mickdassive/car_power_management_sytem/disrabution_controler/hardware/distrabution_controler.kicad_pcb

## KiCad design disrabution_controler/hardware/distrabution_controler.kicad_pcb (2025-07-08)

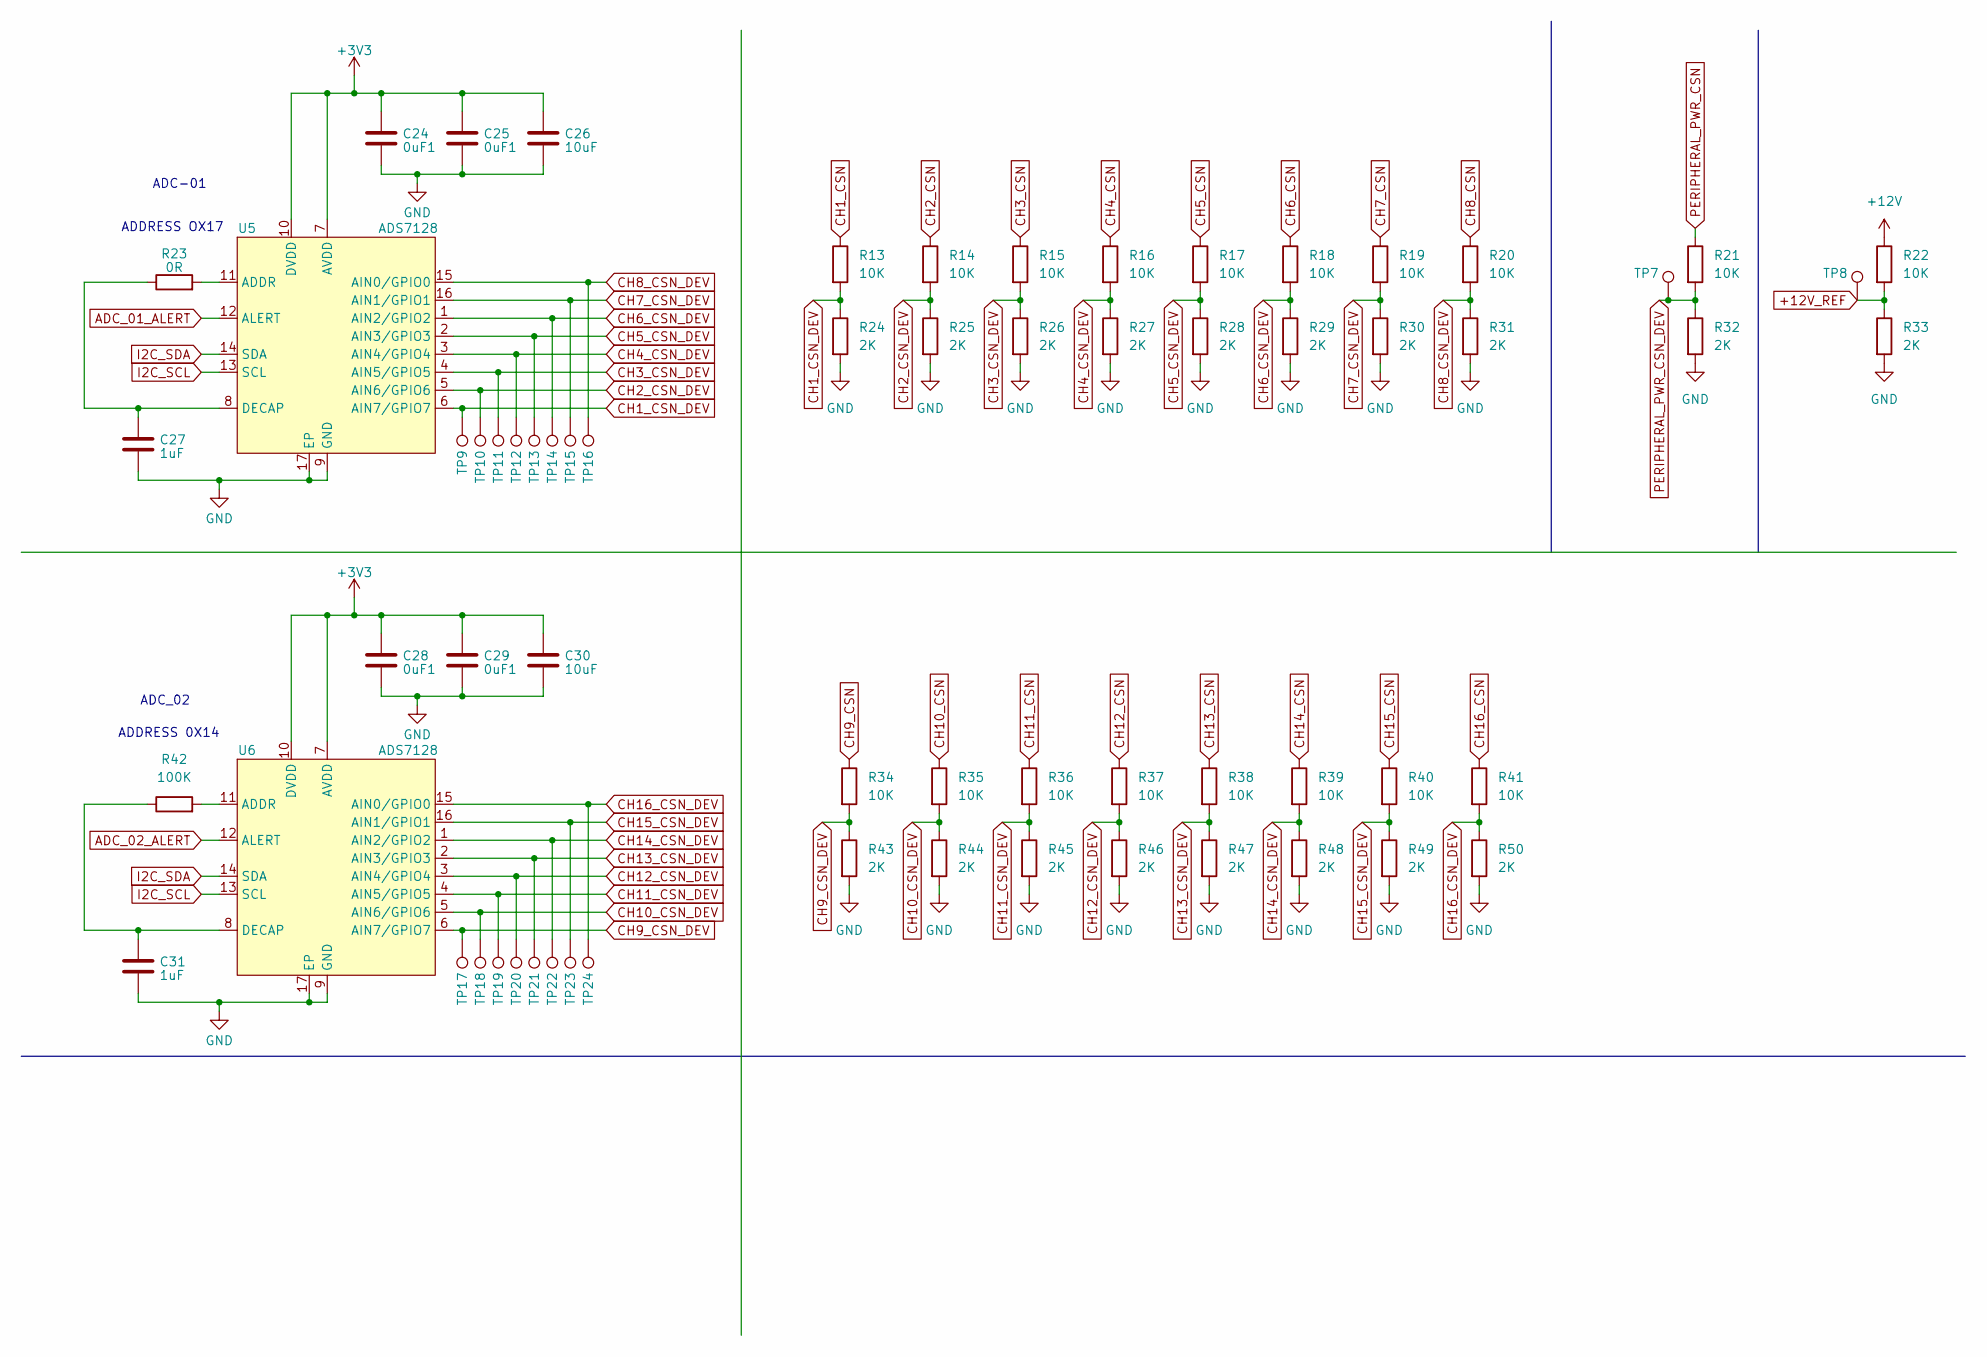
[picture p1: schematic ANALOUGE.kicad_sch]

Parts:
C24, C25, C28, C29: 0uF1; C_0603_1608Metric; Digikey Part Number 399-C0603C104M5RACTUCT-ND
C26, C30: 10uF; C_0603_1608Metric; Digikey Part Number 1276-1038-1-ND
C27, C31: 1uF; C_0603_1608Metric; Digikey Part Number 1276-1946-1-ND
R13, R14, R15, R16, R17, R18, R19, R20, R21, R22, R34, R35, R36, R37, R38, R39, R40, R41: 10K; R_0603_1608Metric; Digikey Part Number RMCF0603JT10K0CT-ND
R23: 0R; R_0603_1608Metric; Digikey Part Number 541-0.0GCT-ND
R24, R25, R26, R27, R28, R29, R30, R31, R32, R33, R43, R44, R45, R46, R47, R48, R49, R50: 2K; R_0603_1608Metric; Digikey Part Number 311-20.0KHRCT-ND
R42: 100K; R_0603_1608Metric; Digikey Part Number 541-100KHCT-ND
TP7, TP8, TP9, TP10, TP11, TP12, TP13, TP14, TP15, TP16, TP17, TP18, TP19, TP20, TP21, TP22, TP23, TP24: TestPoint_Pad_D1.0mm
U5, U6: ADS7128; WQFN-16-1EP_3x3mm_P0.5mm_EP1.6x1.6mm_ThermalVias; Digikey Part Number 296-ADS7128IRTERCT-ND

Connections:
+3V3: C24.1, C25.1, C26.1, C28.1, C29.1, C30.1, U5.7 (AVDD), U5.10 (DVDD), U6.7 (AVDD), U6.10 (DVDD); also elsewhere on the board
+12V: R22.1; also elsewhere on the board
+12V_REF: R22.2, R33.1, TP8.1; also elsewhere on the board
ADC_01_ALERT: U5.12 (ALERT); also elsewhere on the board
ADC_02_ALERT: U6.12 (ALERT); also elsewhere on the board
CH1_CSN: R13.1; also elsewhere on the board
CH1_CSN_DEV: R13.2, R24.1, TP9.1, U5.6 (AIN7/GPIO7)
CH2_CSN: R14.1; also elsewhere on the board
CH2_CSN_DEV: R14.2, R25.1, TP10.1, U5.5 (AIN6/GPIO6)
CH3_CSN: R15.1; also elsewhere on the board
CH3_CSN_DEV: R15.2, R26.1, TP11.1, U5.4 (AIN5/GPIO5)
CH4_CSN: R16.1; also elsewhere on the board
CH4_CSN_DEV: R16.2, R27.1, TP12.1, U5.3 (AIN4/GPIO4)
CH5_CSN: R17.1; also elsewhere on the board
CH5_CSN_DEV: R17.2, R28.1, TP13.1, U5.2 (AIN3/GPIO3)
CH6_CSN: R18.1; also elsewhere on the board
CH6_CSN_DEV: R18.2, R29.1, TP14.1, U5.1 (AIN2/GPIO2)
CH7_CSN: R19.1; also elsewhere on the board
CH7_CSN_DEV: R19.2, R30.1, TP15.1, U5.16 (AIN1/GPIO1)
CH8_CSN: R20.1; also elsewhere on the board
CH8_CSN_DEV: R20.2, R31.1, TP16.1, U5.15 (AIN0/GPIO0)
CH9_CSN: R34.1; also elsewhere on the board
CH9_CSN_DEV: R34.2, R43.1, TP17.1, U6.6 (AIN7/GPIO7)
CH10_CSN: R35.1; also elsewhere on the board
CH10_CSN_DEV: R35.2, R44.1, TP18.1, U6.5 (AIN6/GPIO6)
CH11_CSN: R36.1; also elsewhere on the board
CH11_CSN_DEV: R36.2, R45.1, TP19.1, U6.4 (AIN5/GPIO5)
CH12_CSN: R37.1; also elsewhere on the board
CH12_CSN_DEV: R37.2, R46.1, TP20.1, U6.3 (AIN4/GPIO4)
CH13_CSN: R38.1; also elsewhere on the board
CH13_CSN_DEV: R38.2, R47.1, TP21.1, U6.2 (AIN3/GPIO3)
CH14_CSN: R39.1; also elsewhere on the board
CH14_CSN_DEV: R39.2, R48.1, TP22.1, U6.1 (AIN2/GPIO2)
CH15_CSN: R40.1; also elsewhere on the board
CH15_CSN_DEV: R40.2, R49.1, TP23.1, U6.16 (AIN1/GPIO1)
CH16_CSN: R41.1; also elsewhere on the board
CH16_CSN_DEV: R41.2, R50.1, TP24.1, U6.15 (AIN0/GPIO0)
GND: C24.2, C25.2, C26.2, C27.2, C28.2, C29.2, C30.2, C31.2, R24.2, R25.2, R26.2, R27.2, R28.2, R29.2, R30.2, R31.2, R32.2, R33.2, R43.2, R44.2, R45.2, R46.2, R47.2, R48.2, R49.2, R50.2, U5.9 (GND), U5.17 (EP), U6.9 (GND), U6.17 (EP); also elsewhere on the board
I2C_SCL: U5.13 (SCL), U6.13 (SCL); also elsewhere on the board
I2C_SDA: U5.14 (SDA), U6.14 (SDA); also elsewhere on the board
unnamed: R23.2, U5.11 (ADDR)
unnamed: C27.1, R23.1, U5.8 (DECAP)
unnamed: R42.2, U6.11 (ADDR)
unnamed: C31.1, R42.1, U6.8 (DECAP)
PERIPHERAL_PWR_CSN: R21.1; also elsewhere on the board
PERIPHERAL_PWR_CSN_DEV: R21.2, R32.1, TP7.1; also elsewhere on the board

Notes on the sheet:
ADDRESS OX17
ADC_02
ADC-01
ADDRESS 0X14

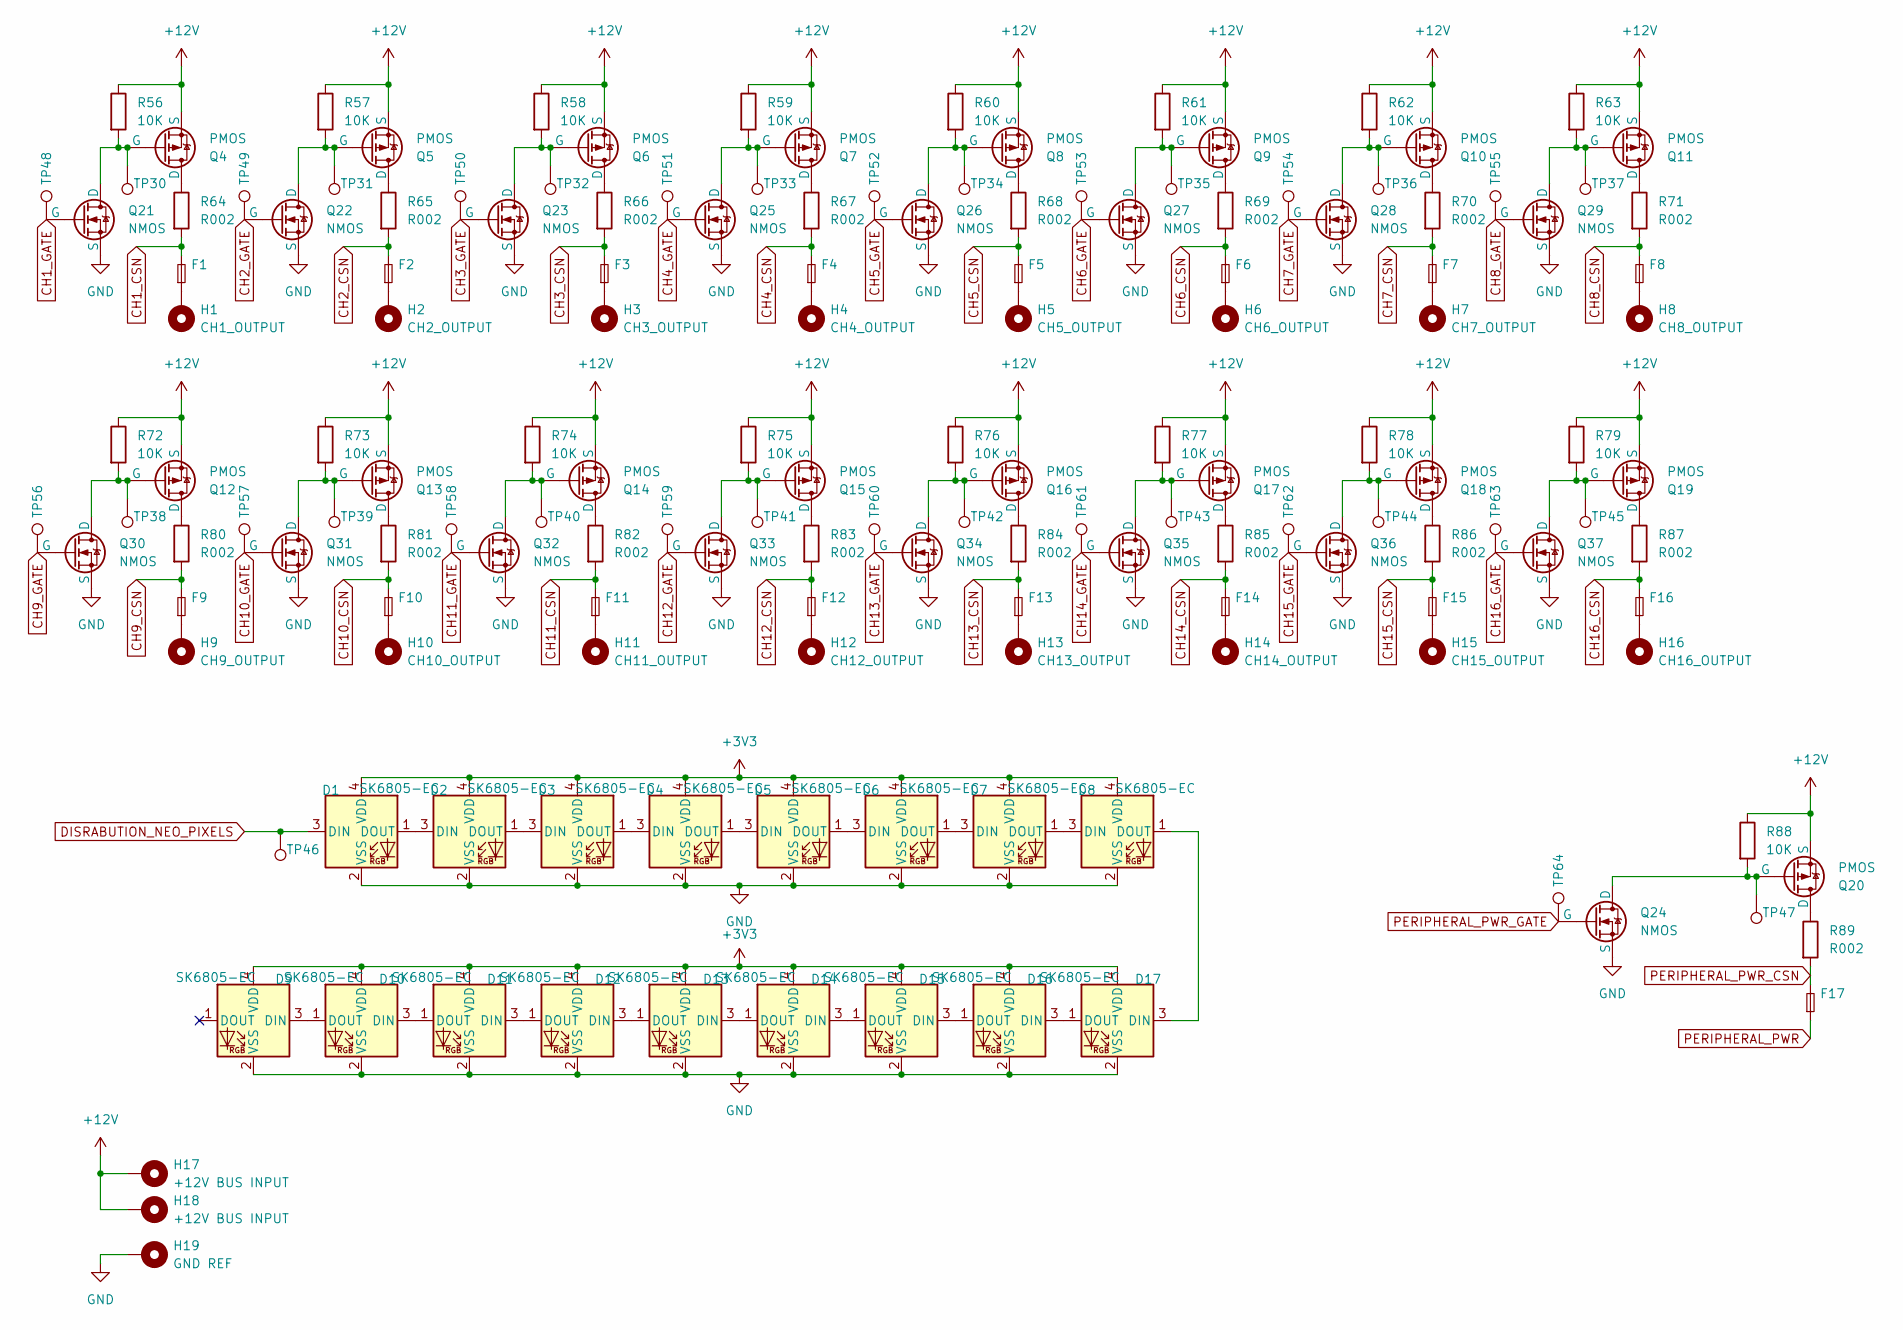
[picture p2: schematic DISTRABUTION.kicad_sch]

Parts:
D1, D2, D3, D4, D5, D6, D7, D8, D9, D10, D11, D12, D13, D14, D15, D16, D17: SK6805-EC; LED_SK6805_PLCC4_2.4x2.7mm_P1.3mm; Digikey Part Number 1528-4492-ND
F1, F2, F3, F4, F5, F6, F7, F8, F9, F10, F11, F12, F13, F14, F15, F16, F17: ATO_FUSEHOLDER; Digikey Part Number 36-3522-ND
H1: CH1_OUTPUT; MountingHole_6.4mm_M6_Pad_TopOnly
H2: CH2_OUTPUT; MountingHole_6.4mm_M6_Pad_TopOnly
H3: CH3_OUTPUT; MountingHole_6.4mm_M6_Pad_TopOnly
H4: CH4_OUTPUT; MountingHole_6.4mm_M6_Pad_TopOnly
H5: CH5_OUTPUT; MountingHole_6.4mm_M6_Pad_TopOnly
H6: CH6_OUTPUT; MountingHole_6.4mm_M6_Pad_TopOnly
H7: CH7_OUTPUT; MountingHole_6.4mm_M6_Pad_TopOnly
H8: CH8_OUTPUT; MountingHole_6.4mm_M6_Pad_TopOnly
H9: CH9_OUTPUT; MountingHole_6.4mm_M6_Pad_TopOnly
H10: CH10_OUTPUT; MountingHole_6.4mm_M6_Pad_TopOnly
H11: CH11_OUTPUT; MountingHole_6.4mm_M6_Pad_TopOnly
H12: CH12_OUTPUT; MountingHole_6.4mm_M6_Pad_TopOnly
H13: CH13_OUTPUT; MountingHole_6.4mm_M6_Pad_TopOnly
H14: CH14_OUTPUT; MountingHole_6.4mm_M6_Pad_TopOnly
H15: CH15_OUTPUT; MountingHole_6.4mm_M6_Pad_TopOnly
H16: CH16_OUTPUT; MountingHole_6.4mm_M6_Pad_TopOnly
H17, H18: +12V BUS INPUT; MountingHole_8.4mm_M8_Pad_TopOnly
H19: GND REF; MountingHole_6.4mm_M6_Pad_TopOnly
Q4, Q5, Q6, Q7, Q8, Q9, Q10, Q11, Q12, Q13, Q14, Q15, Q16, Q17, Q18, Q19, Q20: PMOS; Vishay_PowerPAK_1212-8_Single; Digikey Part Number SISS27DN-T1-GE3CT-ND
Q21, Q22, Q23, Q24, Q25, Q26, Q27, Q28, Q29, Q30, Q31, Q32, Q33, Q34, Q35, Q36, Q37: NMOS; SOT-23; Digikey Part Number BSS127H6327XTSA2CT-ND
R56, R57, R58, R59, R60, R61, R62, R63, R72, R73, R74, R75, R76, R77, R78, R79, R88: 10K; R_0603_1608Metric; Digikey Part Number RMCF0603JT10K0CT-ND
R64, R65, R66, R67, R68, R69, R70, R71, R80, R81, R82, R83, R84, R85, R86, R87, R89: R002; R_2512_6332Metric; Digikey Part Number CRF2512-FZ-R002ELFCT-ND
TP30, TP31, TP32, TP33, TP34, TP35, TP36, TP37, TP38, TP39, TP40, TP41, TP42, TP43, TP44, TP45, TP46, TP47, TP48, TP49, TP50, TP51, TP52, TP53, TP54, TP55, TP56, TP57, TP58, TP59, TP60, TP61, TP62, TP63, TP64: TestPoint_Pad_D1.0mm

Connections:
+3V3: D1.4 (VDD), D2.4 (VDD), D3.4 (VDD), D4.4 (VDD), D5.4 (VDD), D6.4 (VDD), D7.4 (VDD), D8.4 (VDD), D9.4 (VDD), D10.4 (VDD), D11.4 (VDD), D12.4 (VDD), D13.4 (VDD), D14.4 (VDD), D15.4 (VDD), D16.4 (VDD), D17.4 (VDD); also elsewhere on the board
+12V: H17.1, H18.1, Q4.1 (S), Q4.2 (S), Q4.3 (S), Q5.1 (S), Q5.2 (S), Q5.3 (S), Q6.1 (S), Q6.2 (S), Q6.3 (S), Q7.1 (S), Q7.2 (S), Q7.3 (S), Q8.1 (S), Q8.2 (S), Q8.3 (S), Q9.1 (S), Q9.2 (S), Q9.3 (S), Q10.1 (S), Q10.2 (S), Q10.3 (S), Q11.1 (S), Q11.2 (S), Q11.3 (S), Q12.1 (S), Q12.2 (S), Q12.3 (S), Q13.1 (S), Q13.2 (S), Q13.3 (S), Q14.1 (S), Q14.2 (S), Q14.3 (S), Q15.1 (S), Q15.2 (S), Q15.3 (S), Q16.1 (S), Q16.2 (S), Q16.3 (S), Q17.1 (S), Q17.2 (S), Q17.3 (S), Q18.1 (S), Q18.2 (S), Q18.3 (S), Q19.1 (S), Q19.2 (S), Q19.3 (S), Q20.1 (S), Q20.2 (S), Q20.3 (S), R56.1, R57.1, R58.1, R59.1, R60.1, R61.1, R62.1, R63.1, R72.1, R73.1, R74.1, R75.1, R76.1, R77.1, R78.1, R79.1, R88.1; also elsewhere on the board
CH1_CSN: F1.2, R64.2; also elsewhere on the board
CH1_GATE: Q21.1 (G), TP48.1; also elsewhere on the board
CH2_CSN: F2.2, R65.2; also elsewhere on the board
CH2_GATE: Q22.1 (G), TP49.1; also elsewhere on the board
CH3_CSN: F3.2, R66.2; also elsewhere on the board
CH3_GATE: Q23.1 (G), TP50.1; also elsewhere on the board
CH4_CSN: F4.2, R67.2; also elsewhere on the board
CH4_GATE: Q25.1 (G), TP51.1; also elsewhere on the board
CH5_CSN: F5.2, R68.2; also elsewhere on the board
CH5_GATE: Q26.1 (G), TP52.1; also elsewhere on the board
CH6_CSN: F6.2, R69.2; also elsewhere on the board
CH6_GATE: Q27.1 (G), TP53.1; also elsewhere on the board
CH7_CSN: F7.2, R70.2; also elsewhere on the board
CH7_GATE: Q28.1 (G), TP54.1; also elsewhere on the board
CH8_CSN: F8.2, R71.2; also elsewhere on the board
CH8_GATE: Q29.1 (G), TP55.1; also elsewhere on the board
CH9_CSN: F9.2, R80.2; also elsewhere on the board
CH9_GATE: Q30.1 (G), TP56.1; also elsewhere on the board
CH10_CSN: F10.2, R81.2; also elsewhere on the board
CH10_GATE: Q31.1 (G), TP57.1; also elsewhere on the board
CH11_CSN: F11.2, R82.2; also elsewhere on the board
CH11_GATE: Q32.1 (G), TP58.1; also elsewhere on the board
CH12_CSN: F12.2, R83.2; also elsewhere on the board
CH12_GATE: Q33.1 (G), TP59.1; also elsewhere on the board
CH13_CSN: F13.2, R84.2; also elsewhere on the board
CH13_GATE: Q34.1 (G), TP60.1; also elsewhere on the board
CH14_CSN: F14.2, R85.2; also elsewhere on the board
CH14_GATE: Q35.1 (G), TP61.1; also elsewhere on the board
CH15_CSN: F15.2, R86.2; also elsewhere on the board
CH15_GATE: Q36.1 (G), TP62.1; also elsewhere on the board
CH16_CSN: F16.2, R87.2; also elsewhere on the board
CH16_GATE: Q37.1 (G), TP63.1; also elsewhere on the board
DISRABUTION_NEO_PIXELS: D1.3 (DIN), TP46.1; also elsewhere on the board
GND: D1.2 (VSS), D2.2 (VSS), D3.2 (VSS), D4.2 (VSS), D5.2 (VSS), D6.2 (VSS), D7.2 (VSS), D8.2 (VSS), D9.2 (VSS), D10.2 (VSS), D11.2 (VSS), D12.2 (VSS), D13.2 (VSS), D14.2 (VSS), D15.2 (VSS), D16.2 (VSS), D17.2 (VSS), H19.1, Q21.2 (S), Q22.2 (S), Q23.2 (S), Q24.2 (S), Q25.2 (S), Q26.2 (S), Q27.2 (S), Q28.2 (S), Q29.2 (S), Q30.2 (S), Q31.2 (S), Q32.2 (S), Q33.2 (S), Q34.2 (S), Q35.2 (S), Q36.2 (S), Q37.2 (S); also elsewhere on the board
unnamed: D1.1 (DOUT), D2.3 (DIN)
unnamed: D2.1 (DOUT), D3.3 (DIN)
unnamed: D3.1 (DOUT), D4.3 (DIN)
unnamed: D4.1 (DOUT), D5.3 (DIN)
unnamed: D5.1 (DOUT), D6.3 (DIN)
unnamed: D6.1 (DOUT), D7.3 (DIN)
unnamed: D7.1 (DOUT), D8.3 (DIN)
unnamed: D10.3 (DIN), D11.1 (DOUT)
unnamed: D9.3 (DIN), D10.1 (DOUT)
unnamed: D11.3 (DIN), D12.1 (DOUT)
unnamed: D12.3 (DIN), D13.1 (DOUT)
unnamed: D13.3 (DIN), D14.1 (DOUT)
unnamed: D14.3 (DIN), D15.1 (DOUT)
unnamed: D15.3 (DIN), D16.1 (DOUT)
unnamed: D16.3 (DIN), D17.1 (DOUT)
unnamed: D8.1 (DOUT), D17.3 (DIN)
unnamed: F1.1, H1.1
unnamed: F2.1, H2.1
unnamed: F3.1, H3.1
unnamed: F4.1, H4.1
unnamed: F5.1, H5.1
unnamed: F6.1, H6.1
unnamed: F7.1, H7.1
unnamed: F8.1, H8.1
unnamed: F9.1, H9.1
unnamed: F10.1, H10.1
unnamed: F11.1, H11.1
unnamed: F12.1, H12.1
unnamed: F13.1, H13.1
unnamed: F14.1, H14.1
unnamed: F15.1, H15.1
unnamed: F16.1, H16.1
unnamed: Q4.5 (D), R64.1
unnamed: Q5.5 (D), R65.1
unnamed: Q6.5 (D), R66.1
unnamed: Q7.5 (D), R67.1
unnamed: Q8.5 (D), R68.1
unnamed: Q9.5 (D), R69.1
unnamed: Q10.5 (D), R70.1
unnamed: Q10.4 (G), Q28.3 (D), R62.2, TP36.1
unnamed: Q11.5 (D), R71.1
unnamed: Q11.4 (G), Q29.3 (D), R63.2, TP37.1
unnamed: Q12.5 (D), R80.1
unnamed: Q12.4 (G), Q30.3 (D), R72.2, TP38.1
unnamed: Q13.5 (D), R81.1
unnamed: Q13.4 (G), Q31.3 (D), R73.2, TP39.1
unnamed: Q14.5 (D), R82.1
unnamed: Q14.4 (G), Q32.3 (D), R74.2, TP40.1
unnamed: Q15.5 (D), R83.1
unnamed: Q15.4 (G), Q33.3 (D), R75.2, TP41.1
unnamed: Q16.5 (D), R84.1
unnamed: Q16.4 (G), Q34.3 (D), R76.2, TP42.1
unnamed: Q17.5 (D), R85.1
unnamed: Q17.4 (G), Q35.3 (D), R77.2, TP43.1
unnamed: Q18.5 (D), R86.1
unnamed: Q18.4 (G), Q36.3 (D), R78.2, TP44.1
unnamed: Q19.5 (D), R87.1
unnamed: Q19.4 (G), Q37.3 (D), R79.2, TP45.1
unnamed: Q20.5 (D), R89.1
unnamed: Q20.4 (G), Q24.3 (D), R88.2, TP47.1
unnamed: Q4.4 (G), Q21.3 (D), R56.2, TP30.1
unnamed: Q5.4 (G), Q22.3 (D), R57.2, TP31.1
unnamed: Q6.4 (G), Q23.3 (D), R58.2, TP32.1
unnamed: Q7.4 (G), Q25.3 (D), R59.2, TP33.1
unnamed: Q8.4 (G), Q26.3 (D), R60.2, TP34.1
unnamed: Q9.4 (G), Q27.3 (D), R61.2, TP35.1
PERIPHERAL_PWR: F17.1; also elsewhere on the board
PERIPHERAL_PWR_CSN: F17.2, R89.2; also elsewhere on the board
PERIPHERAL_PWR_GATE: Q24.1 (G), TP64.1; also elsewhere on the board

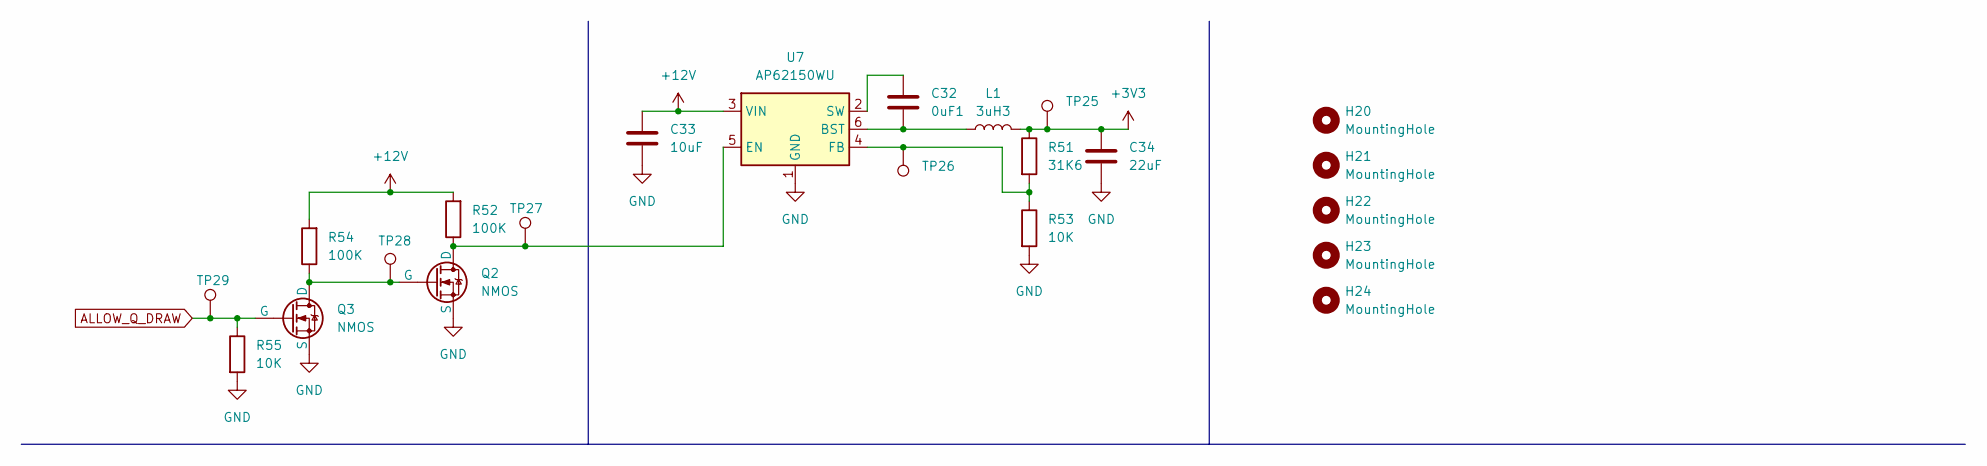
[picture p3: schematic POWER_SUPPLY.kicad_sch]

Parts:
C32: 0uF1; C_0603_1608Metric; Digikey Part Number 399-C0603C104M5RACTUCT-ND
C33: 10uF; C_0603_1608Metric; Digikey Part Number 1276-1038-1-ND
C34: 22uF; C_0603_1608Metric; Digikey Part Number 490-7611-1-ND
H20, H21, H22, H23, H24: MountingHole; MountingHole_4.3mm_M4
L1: 3uH3; L_Bourns_SDR0604; Digikey Part Number 445-173052-1-ND
Q2, Q3: NMOS; SOT-23; Digikey Part Number BSS127H6327XTSA2CT-ND
R51: 31K6; R_0603_1608Metric; Digikey Part Number 541-5351-1-ND
R52, R54: 100K; R_0603_1608Metric; Digikey Part Number 541-100KHCT-ND
R53, R55: 10K; R_0603_1608Metric; Digikey Part Number RMCF0603JT10K0CT-ND
TP25, TP26, TP27, TP28, TP29: TestPoint_Pad_D1.0mm
U7: AP62150WU; TSOT-23-6; Digikey Part Number 31-AP62150WU-7CT-ND

Connections:
+3V3: C34.1, L1.2, R51.1, TP25.1; also elsewhere on the board
+12V: C33.1, R52.2, R54.2, U7.3 (VIN); also elsewhere on the board
ALLOW_Q_DRAW: Q3.1 (G), R55.1, TP29.1; also elsewhere on the board
GND: C33.2, C34.2, Q2.2 (S), Q3.2 (S), R53.2, R55.2, U7.1 (GND); also elsewhere on the board
unnamed: Q2.3 (D), R52.1, TP27.1, U7.5 (EN)
unnamed: Q2.1 (G), Q3.3 (D), R54.1, TP28.1
unnamed: C32.2, L1.1, U7.6 (BST)
unnamed: R51.2, R53.1, TP26.1, U7.4 (FB)
unnamed: C32.1, U7.2 (SW)

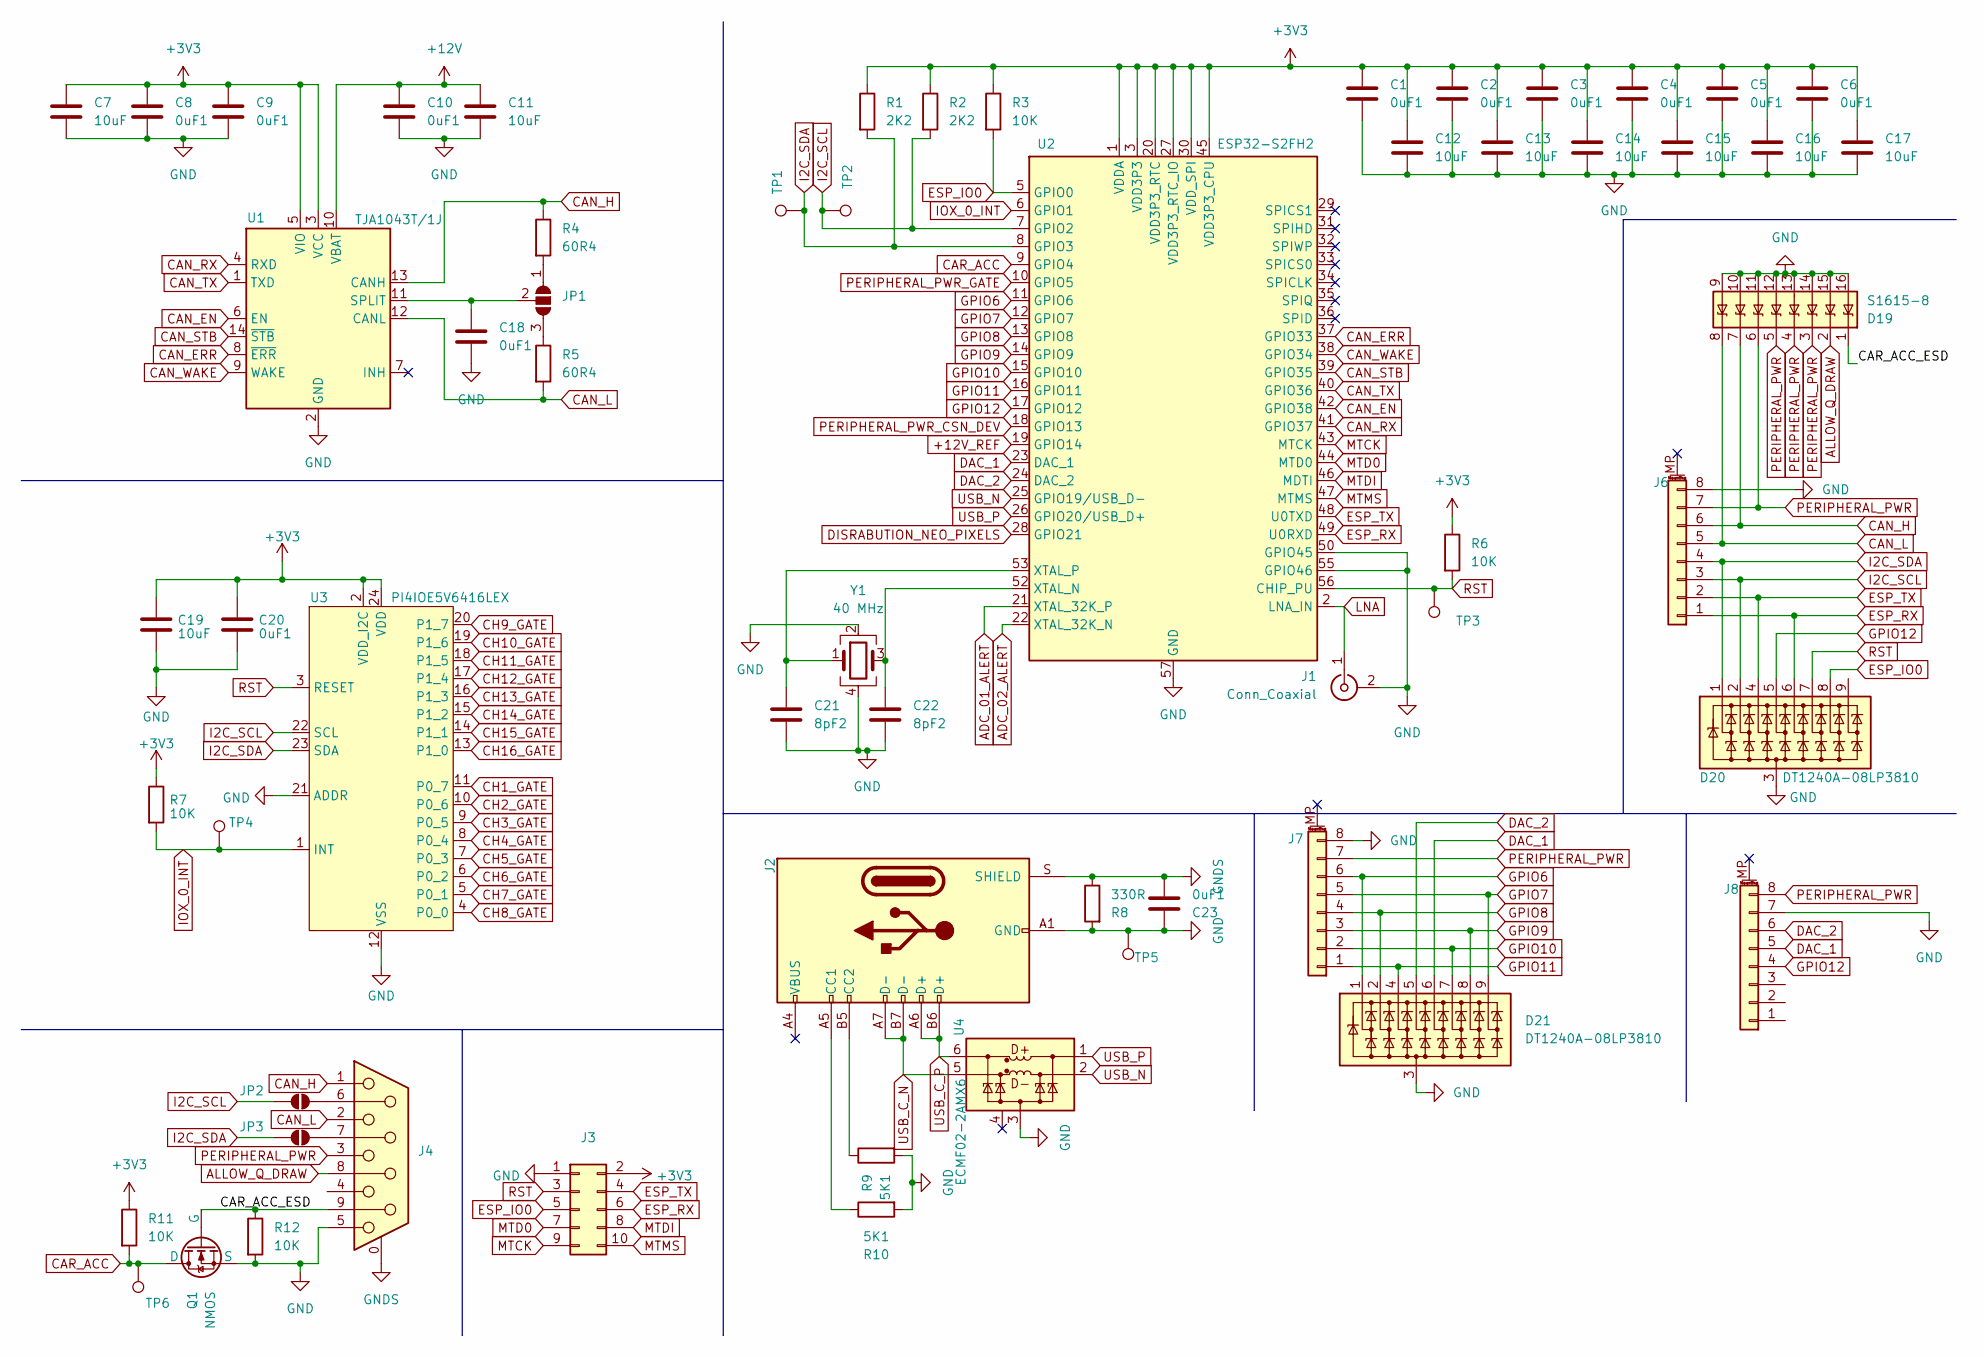
[picture p4: schematic MCU_IO.kicad_sch]

Parts:
C1, C2, C3, C4, C5, C6, C8, C9, C10, C18, C20, C23: 0uF1; C_0603_1608Metric; Digikey Part Number 399-C0603C104M5RACTUCT-ND
C7, C11, C12, C13, C14, C15, C16, C17, C19: 10uF; C_0603_1608Metric; Digikey Part Number 1276-1038-1-ND
C21, C22: 8pF2; C_0603_1608Metric; Digikey Part Number 4713-CHV0603N2508R2BCT-ND
D19: S1615-8; SO-16_5.3x10.2mm_P1.27mm
D20, D21: DT1240A-08LP3810; UDFN-9_1.0x3.8mm_P0.5mm
J1: Conn_Coaxial; SMA_Amphenol_132291-12_Vertical; Digikey Part Number CONREVSMA001-G-ND
J2: usb4500; Digikey Part Number 2073-USB4500-03-0-ACT-ND
J3: PinHeader_2x05_P2.54mm_Vertical; Digikey Part Number S9169-ND
J4: DSUB-9_Pins_Horizontal_P2.77x2.84mm_EdgePinOffset4.94mm_Hou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; Digikey Part Number AE10921-ND
J6, J7, J8: PhoenixContact_MC_1,5_8-GF-3.81_1x08_P3.81mm_Horizontal_Thr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
JP1: SolderJumper-3_P2.0mm_Open_TrianglePad1.0x1.5mm
JP2, JP3: SolderJumper-2_P1.3mm_Open_TrianglePad1.0x1.5mm
Q1: NMOS; SOT-23; Digikey Part Number BSS127H6327XTSA2CT-ND
R1, R2: 2K2; R_0603_1608Metric; Digikey Part Number 541-1.00KHCT-ND
R3, R6, R7, R11, R12: 10K; R_0603_1608Metric; Digikey Part Number RMCF0603JT10K0CT-ND
R4, R5: 60R4; R_0603_1608Metric; Digikey Part Number 541-5507-1-ND
R8: 330R; R_0603_1608Metric; Digikey Part Number 541-4026-1-ND
R9, R10: 5K1; R_0603_1608Metric; Digikey Part Number 541-4030-1-ND
TP1, TP2, TP3, TP4, TP5, TP6: TestPoint_Pad_D1.0mm
U1: TJA1043T/1J; SOIC-14_3.9x8.7mm_P1.27mm; Digikey Part Number 568-13274-1-ND
U2: ESP32-S2FH2; QFN-56-1EP_7x7mm_P0.4mm_EP4x4mm; Digikey Part Number 1904-ESP32-S2FH2CT-ND
U3: PI4IOE5V6416LEX; TSSOP-24_4.4x7.8mm_P0.65mm; Digikey Part Number PI4IOE5V6416LEXDICT-ND
U4: ECMF02-2AMX6; ST_UQFN-6L_1.5x1.7mm_P0.5mm; Digikey Part Number 497-10773-1-ND
Y1: 40 MHz; cx3225sa_e; Digikey Part Number 478-CX3225SA40000D0PTWCCCT-ND

Connections:
+3V3: C1.1, C2.1, C3.1, C4.1, C5.1, C6.1, C7.1, C8.1, C9.1, C12.1, C13.1, C14.1, C15.1, C16.1, C17.1, C19.1, C20.1, J3.2, R1.1, R2.1, R3.1, R6.1, R7.1, R11.1, U1.3 (VCC), U1.5 (VIO), U2.1 (VDDA), U2.3 (VDD3P3), U2.4 (VDD3P3), U2.20 (VDD3P3_RTC), U2.27 (VDD3P3_RTC_IO), U2.30 (VDD_SPI), U2.45 (VDD3P3_CPU), U2.51 (VDDA), U2.54 (VDDA), U3.2 (VDD_I2C), U3.24 (VDD); also elsewhere on the board
+12V: C10.1, C11.1, U1.10 (VBAT); also elsewhere on the board
+12V_REF: U2.19 (GPIO14); also elsewhere on the board
/MCU_IO/CAR_ACC_ESD: D19.1 (Line-1), J4.9, Q1.1 (G), R12.1
ADC_01_ALERT: U2.21 (XTAL_32K_P); also elsewhere on the board
ADC_02_ALERT: U2.22 (XTAL_32K_N); also elsewhere on the board
ALLOW_Q_DRAW: D19.2 (Line-3), J4.8; also elsewhere on the board
CAN_EN: U1.6 (EN), U2.42 (GPIO38)
CAN_ERR: U1.8 (~ERR), U2.37 (GPIO33)
CAN_H: D19.7 (Line-4), J4.1, J6.6, R4.1, U1.13 (CANH)
CAN_L: D19.8 (Line-2), J4.2, J6.5, R5.2, U1.12 (CANL)
CAN_RX: U1.4 (RXD), U2.41 (GPIO37)
CAN_STB: U1.14 (~STB), U2.39 (GPIO35)
CAN_TX: U1.1 (TXD), U2.40 (GPIO36)
CAN_WAKE: U1.9 (WAKE), U2.38 (GPIO34)
CAR_ACC: Q1.3 (D), R11.2, TP6.1, U2.9 (GPIO4)
CH1_GATE: U3.11 (P0_7); also elsewhere on the board
CH2_GATE: U3.10 (P0_6); also elsewhere on the board
CH3_GATE: U3.9 (P0_5); also elsewhere on the board
CH4_GATE: U3.8 (P0_4); also elsewhere on the board
CH5_GATE: U3.7 (P0_3); also elsewhere on the board
CH6_GATE: U3.6 (P0_2); also elsewhere on the board
CH7_GATE: U3.5 (P0_1); also elsewhere on the board
CH8_GATE: U3.4 (P0_0); also elsewhere on the board
CH9_GATE: U3.20 (P1_7); also elsewhere on the board
CH10_GATE: U3.19 (P1_6); also elsewhere on the board
CH11_GATE: U3.18 (P1_5); also elsewhere on the board
CH12_GATE: U3.17 (P1_4); also elsewhere on the board
CH13_GATE: U3.16 (P1_3); also elsewhere on the board
CH14_GATE: U3.15 (P1_2); also elsewhere on the board
CH15_GATE: U3.14 (P1_1); also elsewhere on the board
CH16_GATE: U3.13 (P1_0); also elsewhere on the board
DAC_1: D21.6 (K5), J8.5, U2.23 (DAC_1)
DAC_2: D21.5 (K4), J8.6, U2.24 (DAC_2)
DISRABUTION_NEO_PIXELS: U2.28 (GPIO21); also elsewhere on the board
ESP_IO0: D20.8 (K7), J3.5, R3.2, U2.5 (GPIO0)
ESP_RX: D20.6 (K5), J3.6, J6.1, U2.49 (U0RXD)
ESP_TX: D20.4 (K3), J3.4, J6.2, U2.48 (U0TXD)
GND: C1.2, C2.2, C3.2, C4.2, C5.2, C6.2, C7.2, C8.2, C9.2, C10.2, C11.2, C12.2, C13.2, C14.2, C15.2, C16.2, C17.2, C18.2, C19.2, C20.2, C21.2, C22.2, C23.2, D19.9 (Line-2), D19.10 (Line-4), D19.11, D19.12 (Line-7), D19.13 (Line-8), D19.14 (Line-6), D19.15 (Line-3), D19.16 (Line-1), D20.3 (A), D21.3 (A), J1.2 (Ext), J2.A1 (GND), J2.A12 (GND), J2.B1 (GND), J2.B12 (GND), J3.1, J4.5, J6.8, J7.8, J8.7, Q1.2 (S), R8.2, R9.2, R10.2, R12.2, TP5.1, U1.2 (GND), U2.50 (GPIO45), U2.55 (GPIO46), U2.57 (GND), U3.12 (VSS), U3.21 (ADDR), U4.3 (GND), Y1.2, Y1.4; also elsewhere on the board
GNDS: C23.1, J2.S (SHIELD), J4.0 (PAD), R8.1
GPIO6: D21.1 (K1), J7.6, U2.11 (GPIO6)
GPIO7: D21.9 (K8), J7.5, U2.12 (GPIO7)
GPIO8: D21.2 (K2), J7.4, U2.13 (GPIO8)
GPIO9: D21.8 (K7), J7.3, U2.14 (GPIO9)
GPIO10: D21.7 (K6), J7.2, U2.15 (GPIO10)
GPIO11: D21.4 (K3), J7.1, U2.16 (GPIO11)
GPIO12: D20.5 (K4), J8.4, U2.17 (GPIO12)
I2C_SCL: D20.2 (K2), J6.3, JP2.1 (A), R2.2, TP2.1, U2.7 (GPIO2), U3.22 (SCL); also elsewhere on the board
I2C_SDA: D20.1 (K1), J6.4, JP3.1 (A), R1.2, TP1.1, U2.8 (GPIO3), U3.23 (SDA); also elsewhere on the board
IOX_0_INT: R7.2, TP4.1, U2.6 (GPIO1), U3.1 (INT)
LNA: J1.1 (In), U2.2 (LNA_IN)
MTCK: J3.9, U2.43 (MTCK)
MTD0: J3.7, U2.44 (MTD0)
MTDI: J3.8, U2.46 (MDTI)
MTMS: J3.10, U2.47 (MTMS)
unnamed: J2.A5 (CC1), R10.1
unnamed: J2.B5 (CC2), R9.1
unnamed: JP1.1 (A), R4.2
unnamed: JP1.3 (B), R5.1
unnamed: C18.1, JP1.2 (C), U1.11 (SPLIT)
unnamed: J4.6, JP2.2 (B)
unnamed: J4.7, JP3.2 (B)
unnamed: C22.1, U2.52 (XTAL_N), Y1.3
unnamed: C21.1, U2.53 (XTAL_P), Y1.1
PERIPHERAL_PWR: D19.3 (Line-6), D19.4 (Line-8), D19.5 (Line-7), D19.6 (Line-5), J4.3, J6.7, J7.7, J8.8; also elsewhere on the board
PERIPHERAL_PWR_CSN_DEV: U2.18 (GPIO13); also elsewhere on the board
PERIPHERAL_PWR_GATE: U2.10 (GPIO5); also elsewhere on the board
RST: D20.7 (K6), J3.3, R6.2, TP3.1, U2.56 (CHIP_PU), U3.3 (RESET)
USB_C_N: J2.A7 (D-), J2.B7 (D-), U4.5 (D-_out)
USB_C_P: J2.A6 (D+), J2.B6 (D+), U4.6 (D+_out)
USB_N: U2.25 (GPIO19/USB_D-), U4.2 (D-_in)
USB_P: U2.26 (GPIO20/USB_D+), U4.1 (D+_in)

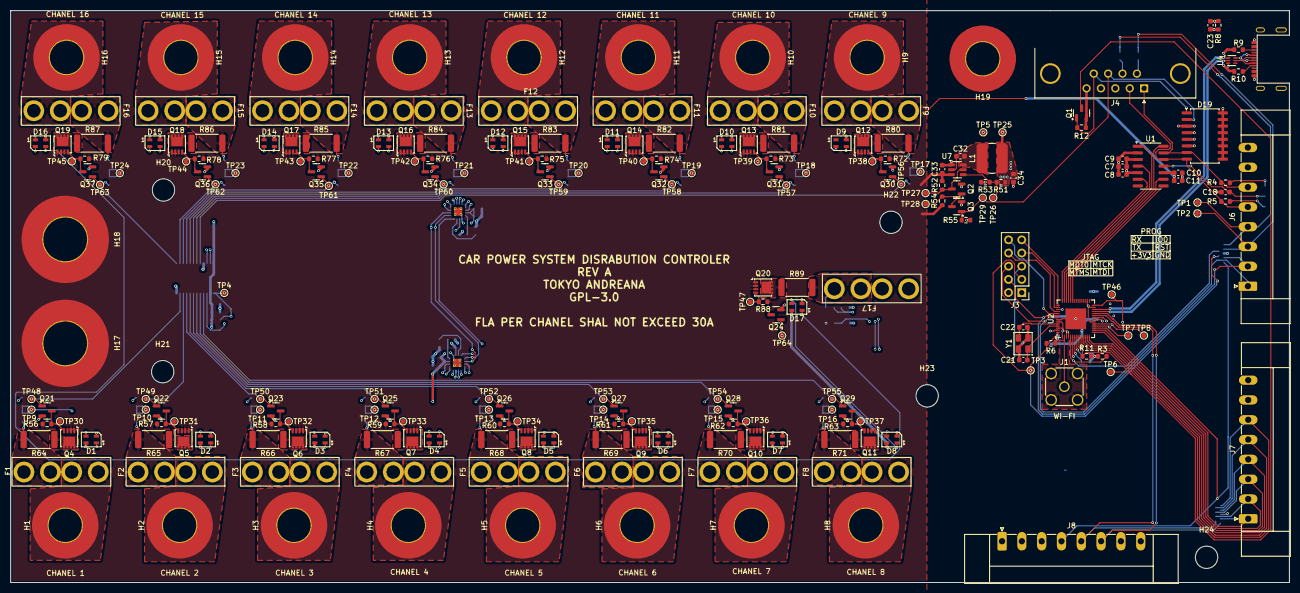
[picture p5: board distrabution_controler.kicad_pcb from above]

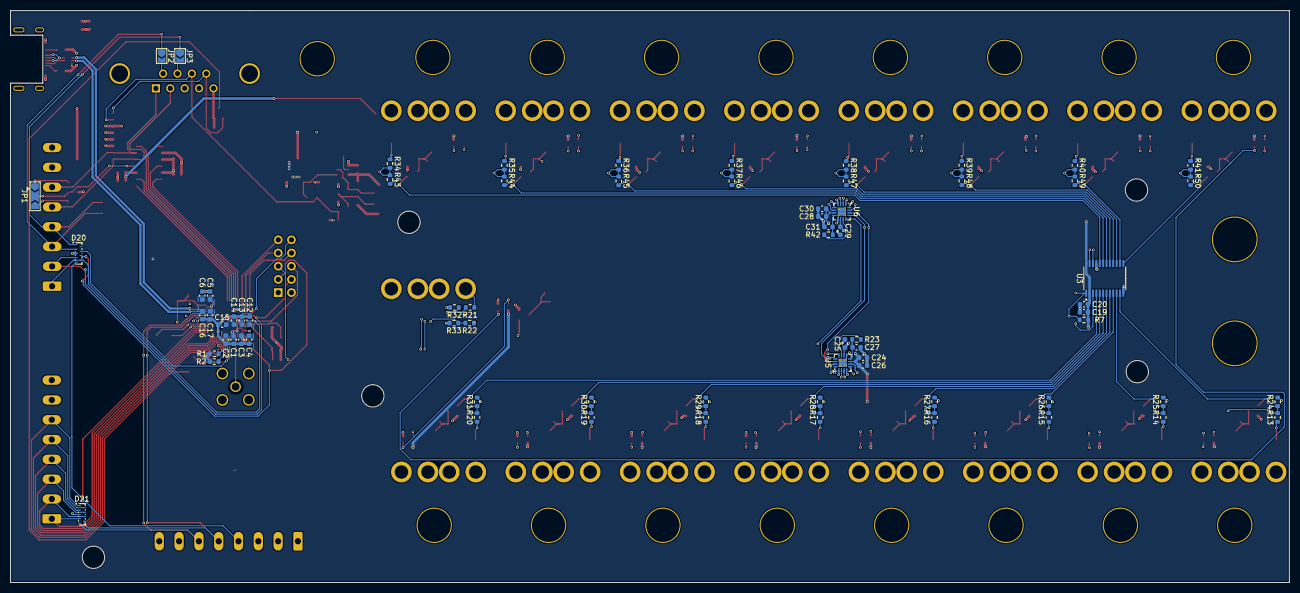
[picture p6: board distrabution_controler.kicad_pcb from below]

Board: 4 copper layers, 246.0 x 110.0 mm, 304 parts (71 on the bottom side), 180 nets.
