mickdassive/car_power_management_sytem/interface_controler/hardware/interface_controler.kicad_pcb

## KiCad design interface_controler/hardware/interface_controler.kicad_pcb (2025-06-06)

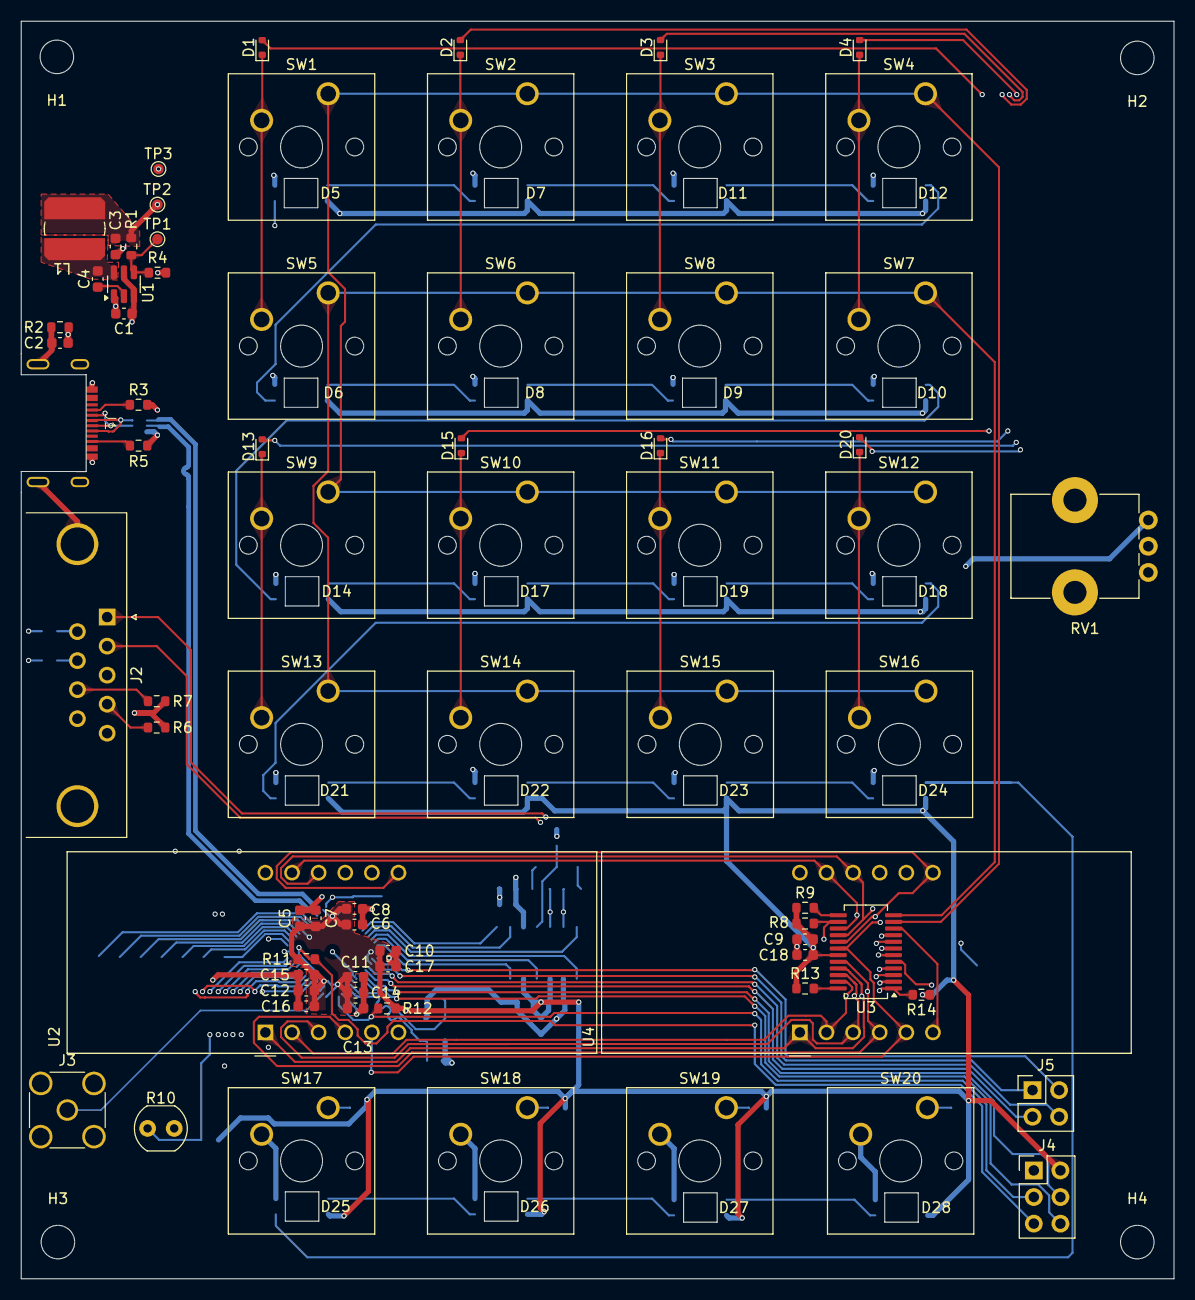
[picture p7: board interface_controler.kicad_pcb from above]

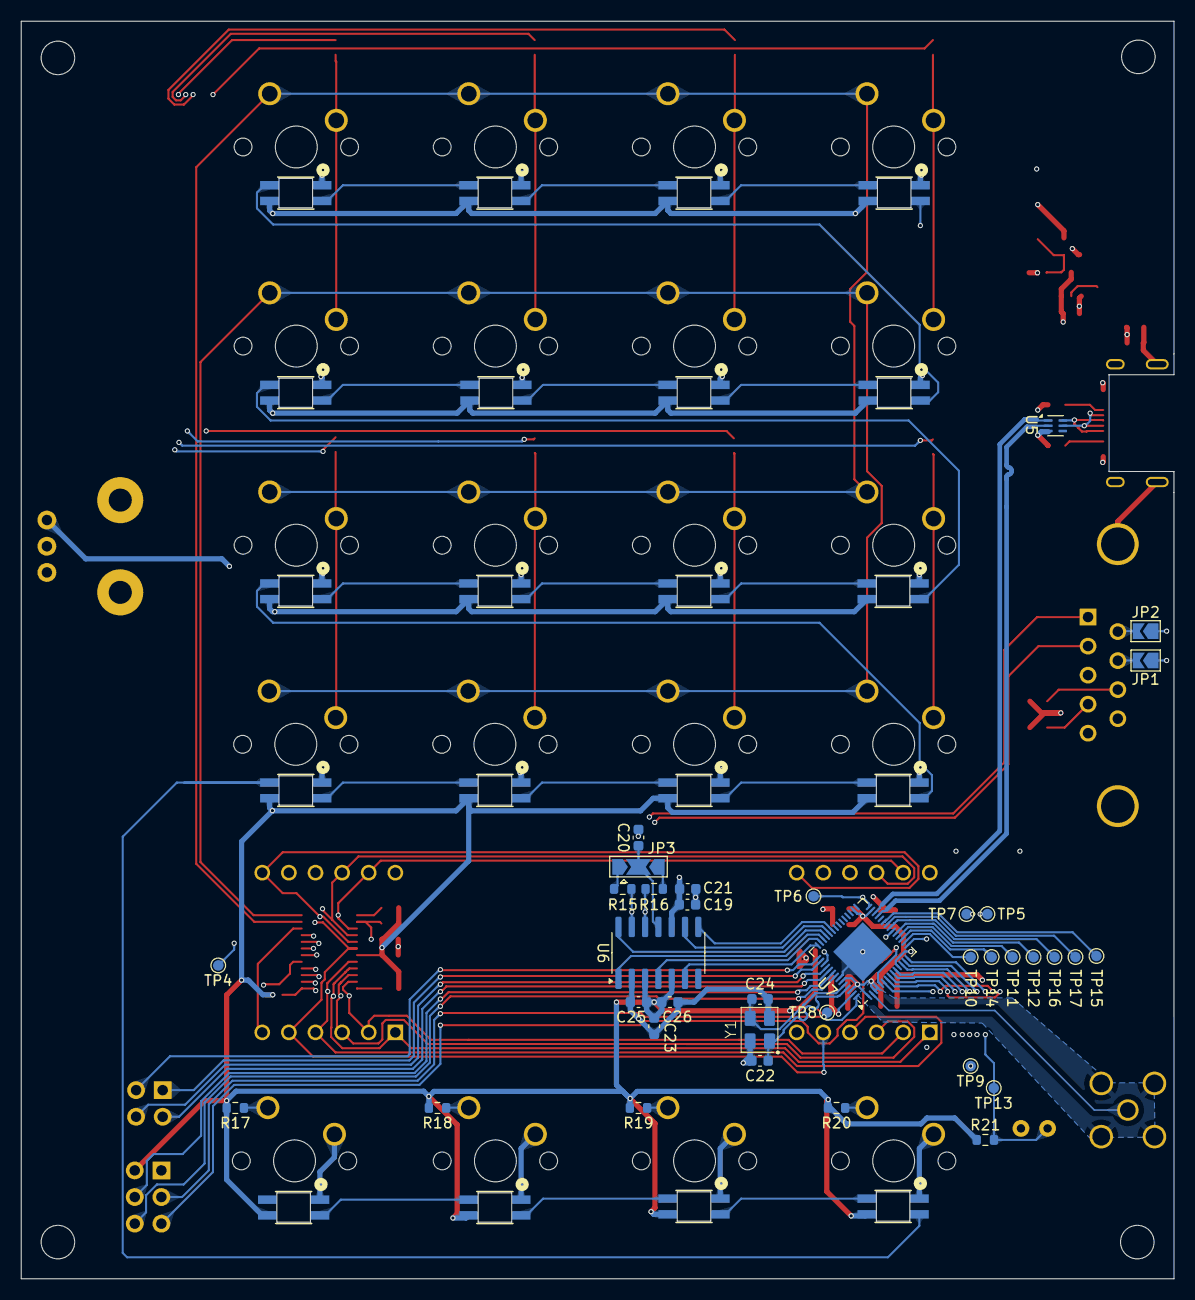
[picture p8: board interface_controler.kicad_pcb from below]

Board: 4 copper layers, 110.0 x 120.0 mm, 134 parts (36 on the bottom side), 104 nets.

Parts:
C1, C6, C7, C9, C10, C11, C13, C15, C19, C23: 10uF; C_0603_1608Metric
C2, C4, C5, C8, C12, C14, C16, C17, C20, C21, C25, C26: 0uF1; C_0603_1608Metric
C3: 22uF; C_0603_1608Metric
C18: 0.1uF; C_0603_1608Metric
C22, C24: 8pF2; C_0603_1608Metric
D1, D2, D3, D4, D13, D15, D16, D20: 1N4448X-TP; D_SOD-523
D5, D6, D7, D8, D9, D10, D11, D12, D14, D17, D18, D19, D21, D22, D23, D24, D25, D26, D27, D28: K6812-E; 4960_ADA
H1, H2, H3, H4: MountingHole; MountingHole_3.2mm_M3
J1: usb4500
J2: DSUB-9_Pins_Horizontal_P2.77x2.84mm_EdgePinOffset4.94mm_Hou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
J3: Conn_Coaxial; SMA_Amphenol_132291-12_Vertical
J4: PROG_PORT; PinHeader_2x03_P2.54mm_Vertical
J5: JTAG; PinHeader_2x02_P2.54mm_Vertical
JP1, JP2: SolderJumper-2_P1.3mm_Open_TrianglePad1.0x1.5mm
JP3: SolderJumper-3_P2.0mm_Open_TrianglePad1.0x1.5mm
L1: 3uH3; L_Bourns_SDR0604
R1: 31K6; R_0603_1608Metric
R2: 330R; R_0603_1608Metric
R3, R5: 5K1; R_0603_1608Metric
R4, R6, R7, R9, R11, R12, R13, R17, R18, R19, R20: 10K; R_0603_1608Metric
R8, R14: 2K2; R_0603_1608Metric
R10: PDV-P9203; R_LDR_4.9x4.2mm_P2.54mm_Vertical
R15, R16: 60R4; R_0603_1608Metric
R21: 22K; R_0603_1608Metric
RV1: 10K; Potentiometer_Bourns_PTV09A-1_Single_Vertical
SW1: CH_1; SW_Cherry_MX_1.00u_PCB
SW2: CH_2; SW_Cherry_MX_1.00u_PCB
SW3: CH_3; SW_Cherry_MX_1.00u_PCB
SW4: CH_4; SW_Cherry_MX_1.00u_PCB
SW5: CH_5; SW_Cherry_MX_1.00u_PCB
SW6: CH_6; SW_Cherry_MX_1.00u_PCB
SW7: CH_8; SW_Cherry_MX_1.00u_PCB
SW8: CH_7; SW_Cherry_MX_1.00u_PCB
SW9: CH_9; SW_Cherry_MX_1.00u_PCB
SW10: CH_10; SW_Cherry_MX_1.00u_PCB
SW11: CH_11; SW_Cherry_MX_1.00u_PCB
SW12: CH_12; SW_Cherry_MX_1.00u_PCB
SW13: CH_13; SW_Cherry_MX_1.00u_PCB
SW14: CH_14; SW_Cherry_MX_1.00u_PCB
SW15: CH_15; SW_Cherry_MX_1.00u_PCB
SW16: CH_16; SW_Cherry_MX_1.00u_PCB
SW17: USER_ENTER; SW_Cherry_MX_1.00u_PCB
SW18: USER_UP; SW_Cherry_MX_1.00u_PCB
SW19: USER_DOWN; SW_Cherry_MX_1.00u_PCB
SW20: USER_BACK; SW_Cherry_MX_1.00u_PCB
TP1, TP2, TP3, TP4, TP5, TP6, TP7, TP8, TP9, TP10, TP11, TP12, TP13, TP14, TP15, TP16, TP17: TestPoint_Pad_D1.0mm
U1: AP62150WU; TSOT-23-6
U2, U4: LTC-5723HR; CA56-12CGKWA
U3: AS1115-BSST; QSOP-24_3.9x8.7mm_P0.635mm
U5: ECMF02-2AMX6; ST_UQFN-6L_1.5x1.7mm_P0.5mm
U6: TJA1043T/1J; SOIC-14_3.9x8.7mm_P1.27mm
U7: ESP32-S2FH2; QFN-56-1EP_7x7mm_P0.4mm_EP4x4mm
Y1: 40 MHz; cx3225sa_e

Connections:
+3V3: C3.1, C5.1, C6.1, C7.1, C8.1, C9.1, C10.1, C11.1, C12.1, C13.1, C14.1, C15.1, C16.1, C17.1, C18.1, C23.1, C25.1, C26.1, D5.3 (VDD), D6.3 (VDD), D7.3 (VDD), D8.3 (VDD), D9.3 (VDD), D10.3 (VDD), D11.3 (VDD), D12.3 (VDD), D14.3 (VDD), D17.3 (VDD), D18.3 (VDD), D19.3 (VDD), D21.3 (VDD), D22.3 (VDD), D23.3 (VDD), D24.3 (VDD), D25.3 (VDD), D26.3 (VDD), D27.3 (VDD), D28.3 (VDD), J4.2, L1.2, R1.1, R6.2, R7.2, R8.1, R9.1, R11.1, R12.1, R13.1, R14.1, R17.2, R18.2, R19.2, R20.2, R21.1, RV1.1, TP2.1, U3.19 (VDD), U6.3 (VCC), U6.5 (VIO), U7.1 (VDDA), U7.3 (VDD3P3), U7.4 (VDD3P3), U7.20 (VDD3P3_RTC), U7.27 (VDD3P3_RTC_IO), U7.30 (VDD_SPI), U7.45 (VDD3P3_CPU), U7.51 (VDDA), U7.54 (VDDA)
+12V: C1.1, C19.1, C21.1, J2.3, U1.3 (VIN), U1.5 (EN), U6.10 (VBAT)
BLACKOUT: J2.8, R7.1
CAN_EN: U6.6 (EN), U7.42 (GPIO38)
CAN_ERR: U6.8 (~ERR), U7.37 (GPIO33)
CAN_H: J2.1, R15.1, U6.13 (CANH)
CAN_L: J2.2, R16.2, U6.12 (CANL)
CAN_RX: U6.4 (RXD), U7.41 (GPIO37)
CAN_STB: U6.14 (~STB), U7.39 (GPIO35)
CAN_TX: U6.1 (TXD), U7.40 (GPIO36)
CAN_WAKE: U6.9 (WAKE), U7.38 (GPIO34)
DISP_DIG_0: U2.12 (CC1), U3.2 (DIG0)
DISP_DIG_1: U2.9 (CC2), U3.3 (DIG1)
DISP_DIG_2: U2.8 (CC3), U3.4 (DIG2)
DISP_DIG_3: U2.6 (CC4), U3.5 (DIG3)
DISP_DIG_4: U3.7 (DIG4), U4.12 (CC1)
DISP_DIG_5: U3.8 (DIG5), U4.9 (CC2)
DISP_DIG_6: U3.9 (DIG6), U4.8 (CC3)
DISP_DIG_7: U3.10 (DIG7), U4.6 (CC4)
DISP_IRQ: R13.2, U3.24 (IRQ)
DISP_KEY_A: SW1.1, SW2.1, SW3.1, SW4.1, SW9.1, SW10.1, SW11.1, SW12.1, U3.11 (KEYA)
DISP_KEY_B: SW5.1, SW6.1, SW7.1, SW8.1, SW13.1, SW14.1, SW15.1, SW16.1, U3.12 (KEYB)
DISP_SEG_A: D1.2 (A), U2.11 (a), U3.15 (SEGA), U4.11 (a)
DISP_SEG_B: D2.2 (A), U2.7 (b), U3.17 (SEGB), U4.7 (b)
DISP_SEG_C: D3.2 (A), U2.4 (c), U3.20 (SEGC), U4.4 (c)
DISP_SEG_D: D4.2 (A), U2.2 (d), U3.23 (SEGD), U4.2 (d)
DISP_SEG_DP: D20.2 (A), U2.3 (DPX), U3.22 (SEGDP), U4.3 (DPX)
DISP_SEG_E: D13.2 (A), U2.1 (e), U3.21 (SEGE), U4.1 (e)
DISP_SEG_F: D15.2 (A), U2.10 (f), U3.16 (SEGF), U4.10 (f)
DISP_SEG_G: D16.2 (A), U2.5 (g), U3.18 (SEGG), U4.5 (g)
ESP_IO0: J4.5, R11.2, U7.5 (GPIO0)
ESP_RX: J4.6, U7.49 (U0RXD)
ESP_TX: J4.4, U7.48 (U0TXD)
GND: C1.2, C2.2, C3.2, C5.2, C6.2, C7.2, C8.2, C9.2, C10.2, C11.2, C12.2, C13.2, C14.2, C15.2, C16.2, C17.2, C18.2, C19.2, C20.2, C21.2, C22.2, C23.2, C24.2, C25.2, C26.2, D5.1 (VSS), D6.1 (VSS), D7.1 (VSS), D8.1 (VSS), D9.1 (VSS), D10.1 (VSS), D11.1 (VSS), D12.1 (VSS), D14.1 (VSS), D17.1 (VSS), D18.1 (VSS), D19.1 (VSS), D21.1 (VSS), D22.1 (VSS), D23.1 (VSS), D24.1 (VSS), D25.1 (VSS), D26.1 (VSS), D27.1 (VSS), D28.1 (VSS), J1.A1 (GND), J1.B1 (GND), J2.5, J3.2 (Ext), J4.1, R2.2, R3.2, R4.2, R5.2, R10.2, RV1.3, SW17.2, SW18.2, SW19.2, SW20.2, TP3.1, U1.1 (GND), U3.6 (GND), U5.3 (GND), U6.2 (GND), U7.50 (GPIO45), U7.55 (GPIO46), U7.57 (GND), Y1.2, Y1.4
GNDS: C2.1, J1.S (SHIELD), J2.0 (PAD), R2.1
I2C_SCL: JP2.1 (A), R8.2, TP7.1, U3.14 (SCL), U7.7 (GPIO2)
I2C_SDA: JP1.1 (A), R14.2, TP5.1, U3.1 (SDA), U7.8 (GPIO3)
KB_NEOPIXELS: D5.2 (DIN), U7.15 (GPIO10)
LIGHT_ADJUST: RV1.2, TP4.1, U7.11 (GPIO6)
LIGHT_SENSE: R10.1, R21.2, TP13.1, U7.14 (GPIO9)
LNA: J3.1 (In), U7.2 (LNA_IN)
MTCK: J5.2, U7.43 (MTCK)
MTD0: J5.1, U7.44 (MTD0)
MTDI: J5.4, U7.46 (MDTI)
MTMS: J5.3, U7.47 (MTMS)
unnamed: D1.1 (K), SW1.2, SW5.2
unnamed: D2.1 (K), SW2.2, SW6.2
unnamed: D3.1 (K), SW3.2, SW8.2
unnamed: D4.1 (K), SW4.2, SW7.2
unnamed: D20.1 (K), SW12.2, SW16.2
unnamed: D16.1 (K), SW11.2, SW15.2
unnamed: D15.1 (K), SW10.2, SW14.2
unnamed: D13.1 (K), SW9.2, SW13.2
unnamed: D5.4 (DOUT), D7.2 (DIN)
unnamed: D7.4 (DOUT), D11.2 (DIN)
unnamed: D11.4 (DOUT), D12.2 (DIN)
unnamed: D6.2 (DIN), D12.4 (DOUT)
unnamed: D6.4 (DOUT), D8.2 (DIN)
unnamed: D8.4 (DOUT), D9.2 (DIN)
unnamed: D9.4 (DOUT), D10.2 (DIN)
unnamed: D10.4 (DOUT), D14.2 (DIN)
unnamed: D14.4 (DOUT), D17.2 (DIN)
unnamed: D17.4 (DOUT), D19.2 (DIN)
unnamed: D18.2 (DIN), D19.4 (DOUT)
unnamed: D18.4 (DOUT), D21.2 (DIN)
unnamed: D21.4 (DOUT), D22.2 (DIN)
unnamed: D22.4 (DOUT), D23.2 (DIN)
unnamed: D23.4 (DOUT), D24.2 (DIN)
unnamed: D24.4 (DOUT), D25.2 (DIN)
unnamed: D25.4 (DOUT), D26.2 (DIN)
unnamed: D26.4 (DOUT), D27.2 (DIN)
unnamed: D27.4 (DOUT), D28.2 (DIN)
unnamed: J1.A5 (CC1), R3.1
unnamed: J1.B5 (CC2), R5.1
unnamed: JP3.1 (A), R15.2
unnamed: JP3.3 (B), R16.1
unnamed: C20.1, JP3.2 (C), U6.11 (SPLIT)
unnamed: J2.6, JP2.2 (B)
unnamed: J2.7, JP1.2 (B)
unnamed: TP15.1, U7.23 (DAC_1)
unnamed: TP9.1, U7.6 (GPIO1)
unnamed: TP10.1, U7.16 (GPIO11)
unnamed: TP14.1, U7.17 (GPIO12)
unnamed: TP11.1, U7.18 (GPIO13)
unnamed: TP12.1, U7.19 (GPIO14)
unnamed: TP6.1, U7.28 (GPIO21)
unnamed: TP17.1, U7.22 (XTAL_32K_N)
unnamed: TP16.1, U7.21 (XTAL_32K_P)
unnamed: C24.1, U7.52 (XTAL_N), Y1.3
unnamed: C22.1, U7.53 (XTAL_P), Y1.1
unnamed: R9.2, U3.13 (ISET)
unnamed: C4.2, L1.1, U1.6 (BST)
unnamed: R1.2, R4.1, TP1.1, U1.4 (FB)
unnamed: C4.1, U1.2 (SW)
OFF_ROAD: J2.4, R6.1
RST: J4.3, R12.2, TP8.1, U7.56 (CHIP_PU)
USB_C_N: J1.A7 (D-), J1.B7 (D-), U5.5 (D-_out)
USB_C_P: J1.A6 (D+), J1.B6 (D+), U5.6 (D+_out)
USB_N: U5.2 (D-_in), U7.25 (GPIO19/USB_D-)
USB_P: U5.1 (D+_in), U7.26 (GPIO20/USB_D+)
USER_BACK: R17.1, SW20.1, U7.9 (GPIO4)
USER_DOWN: R18.1, SW19.1, U7.10 (GPIO5)
USER_ENTER: R20.1, SW17.1, U7.13 (GPIO8)
USER_UP: R19.1, SW18.1, U7.12 (GPIO7)
