mickdassive/car_power_management_sytem/disrabution_controler/src/can.cpp

#ifndef can_cpp
#define can_cpp

#include <Arduino.h>
#include "can.h"
#include "DEBUG.h"
#include "io.h"
#include "adc.h"
#include "driver/twai.h"

//status vars
bool can_device_fult = false;
bool can_normal_operateing_mode = true;



/**
 * @brief Sends a CAN frame using the TWAI (CAN) driver.
 *
 * This function prepares a CAN frame based on the provided message structure
 * and attempts to transmit it immediately. The data length is determined by the
 * 'data_length_code' member of the message struct, which must be set to the number
 * of valid bytes in the data array. If the transmit buffer is full,
 * it logs the event and (optionally) notifies a FreeRTOS task to retry sending.
 *
 * @param message_to_send The message structure containing CAN frame parameters:
 *   - id: CAN identifier.
 *   - extended: Whether to use extended frame format.
 *   - type: Frame type (e.g., data or RTR).
 *   - single_shot: Whether to use single shot transmission.
 *   - data: Array of data bytes to send.
 *   - data_length_code: Number of valid bytes in the data array to send.
 *
 * @note
 * - The function uses debug_msg for logging.
 * - If transmission fails due to a full buffer, notification to a sender task
 *   is possible (see commented code).
 * - Assumes the existence of a FreeRTOS task handle (canSenderTaskHandle) if
 *   notification is enabled.
 * - If the data array is not fully used, only the first 'data_length_code' bytes are sent.
 */
void can_send_frame(struct message message_to_send) {

  debug_msg(DEBUG_PARTIAL_CAN, "can_send_frame called", false, 0);

  // Calculate data length code based on number of non-zero bytes in data
  uint8_t dlc = 0;
  for (int i = 0; i < 8; i++) {
    if (message_to_send.data[i] != 0) {
      dlc = i + 1;
    }
  }

  //setup frame
  twai_message_t frame;
  frame.extd = message_to_send.extended; // Set extended frame format
  frame.rtr = (message_to_send.type == FRAME_RTR); // Set RTR flag if frame type is RTR
  frame.ss = message_to_send.single_shot; // Set single shot transmission flag
  frame.identifier = message_to_send.id; // Set the CAN ID
  frame.data_length_code = dlc; // Set the data length code to number of non-zero bytes
  for (int i = 0; i < dlc; i++) {
    frame.data[i] = message_to_send.data[i]; // Copy only valid data bytes into the frame
  }

  // Try to send frame without blocking indefinitely
  if (twai_transmit(&frame, 0) == ESP_OK) {
    debug_msg(DEBUG_PARTIAL_CAN, "Frame sent successfully", false, 0);
  } else {
    debug_msg(DEBUG_PARTIAL_CAN, "Transmit buffer full, notifying sender task", false, 0);
    // Notify a FreeRTOS task to retry sending later
    // Assume you have a TaskHandle_t canSenderTaskHandle defined elsewhere
    /*
    BaseType_t xHigherPriorityTaskWoken = pdFALSE;
    vTaskNotifyGiveFromISR(canSenderTaskHandle, &xHigherPriorityTaskWoken);
    portYIELD_FROM_ISR(xHigherPriorityTaskWoken);
    // Optionally, add the frame to a queue for the sender task to process\
    */
  }

  return;
}


/**
 * @brief Initializes the CAN (Controller Area Network) bus using the TWAI driver.
 *
 * This function sets up the CAN bus by configuring the general, timing, and filter parameters
 * using default macro initializers. It installs and starts the TWAI driver, and provides debug
 * messages at each step to indicate success or failure.
 *
 * Steps performed:
 * - Initializes configuration structures for general, timing, and filter settings.
 * - Installs the TWAI driver with the specified configurations.
 * - Starts the TWAI driver if installation is successful.
 * - Outputs debug messages for each major step and error condition.
 *
 * @note This function assumes that the `can_tx` and `can_rx` pin numbers are properly set.
 * @note Uses 500 Kbps as the CAN bus speed and accepts all CAN frames by default.
 */
void can_init() {
  debug_msg(DEBUG_PARTIAL_CAN, "can_init called, initializing CAN bus", false, 0);

  //enable can phy
  io_call(can_en, WRITE, high);
  io_call(can_stb, WRITE, high);
  debug_msg(DEBUG_PARTIAL_CAN, "CAN PHY enabled", false, 0);

  // Initialize configuration structures using macro initializers
  twai_general_config_t g_config = TWAI_GENERAL_CONFIG_DEFAULT((gpio_num_t)can_tx.pin_number,
   (gpio_num_t)can_rx.pin_number,
   TWAI_MODE_NORMAL);
   
  twai_timing_config_t t_config = TWAI_TIMING_CONFIG_500KBITS();
  twai_filter_config_t f_config = TWAI_FILTER_CONFIG_ACCEPT_ALL();

  // install the TWAI driver
  if (twai_driver_install(&g_config, &t_config, &f_config) != ESP_OK) {
    debug_msg(DEBUG_PARTIAL_CAN, "Failed to install TWAI driver", false, 0);
    return;
  } else {
    debug_msg(DEBUG_PARTIAL_CAN, "TWAI driver installed successfully", false, 0);
  }

  // Start the TWAI driver
  if (twai_start() != ESP_OK) {
    debug_msg(DEBUG_PARTIAL_CAN, "Failed to start TWAI driver", false, 0);
    return;
  } else {
    debug_msg(DEBUG_PARTIAL_CAN, "TWAI driver started successfully", false, 0);
  }

  // setup alerts
  twai_reconfigure_alerts(
    TWAI_ALERT_TX_IDLE |
    TWAI_ALERT_TX_SUCCESS |
    TWAI_ALERT_RX_DATA |
    TWAI_ALERT_BUS_ERROR |
    TWAI_ALERT_TX_FAILED |
    TWAI_ALERT_RX_QUEUE_FULL,
    nullptr
  );

  debug_msg(DEBUG_PARTIAL_CAN, "CAN bus initialized", false, 0);

  return;
}

/**
 * @brief Reads a received CAN frame from the TWAI bus.
 *
 * This function attempts to receive a CAN frame from the TWAI bus within a 1000 ms timeout.
 * If a frame is successfully received, it populates a `messaage` struct with the frame's
 * identifier, extended flag, frame type (data or remote), single shot flag, and data bytes.
 * Debug messages are logged for both successful and unsuccessful receive attempts.
 *
 * @return struct message The received CAN message. If no frame is received or an error occurs,
 *         the returned struct may contain uninitialized data.
 */
struct message can_read_received_frame() {
  debug_msg(DEBUG_PARTIAL_CAN, "can_read_received_frame called", false, 0);

  twai_message_t frame;
  struct message received_message;

  // Read a frame from the TWAI bus
  if (twai_receive(&frame, pdMS_TO_TICKS(1000)) == ESP_OK) {
    debug_msg(DEBUG_PARTIAL_CAN, "Frame received successfully", false, 0);
    received_message.id = frame.identifier;
    received_message.extended = frame.extd;
    received_message.type = (frame.rtr) ? FRAME_RTR : FRAME_DATA;
    received_message.single_shot = frame.ss;
    received_message.data_length_code = frame.data_length_code;
    for (int i = 0; i < frame.data_length_code; i++) {
      received_message.data[i] = frame.data[i];
    }
  } else {
    debug_msg(DEBUG_PARTIAL_CAN, "No frame received or error occurred", false, 0);
  }

  return received_message;
}

/**
 * @brief Task function to monitor and handle CAN (TWAI) controller alerts.
 *
 * This function continuously checks for various alerts from the CAN controller,
 * such as transmission success, transmission idle, reception of data, bus errors,
 * transmission failures, and receive queue overflows. For each detected alert,
 * it logs a corresponding debug message. The function is intended to run as a FreeRTOS task.
 *
 * @param pvParameters Pointer to task parameters (unused).
 *
 * Alerts handled:
 * - TWAI_ALERT_TX_IDLE: No more messages to send.
 * - TWAI_ALERT_TX_SUCCESS: CAN frame sent successfully.
 * - TWAI_ALERT_RX_DATA: Data received.
 * - TWAI_ALERT_BUS_ERROR: Bus error detected.
 * - TWAI_ALERT_TX_FAILED: Transmission failed.
 * - TWAI_ALERT_RX_QUEUE_FULL: Receive queue is full.
 *
 * The function includes a delay to avoid busy-waiting.
 */
void can_check_for_alerts (void *pvParameters) {

  debug_msg(DEBUG_PARTIAL_CAN, "can_check_for_alerts called", false, 0);

  uint32_t triggered_alerts;

  for (;;) {

    twai_read_alerts(&triggered_alerts, pdMS_TO_TICKS(100));

    if (triggered_alerts & TWAI_ALERT_TX_IDLE) {

      debug_msg(DEBUG_PARTIAL_CAN, "TX Idle no more messages to send", false, 0);

    } else if (triggered_alerts & TWAI_ALERT_TX_SUCCESS) {

      debug_msg(DEBUG_PARTIAL_CAN, "can frame sent successfully", false, 0);

    } else if (triggered_alerts & TWAI_ALERT_RX_DATA) {

      debug_msg(DEBUG_PARTIAL_CAN, "RX Data alert triggered", false, 0);

      // Read the received CAN frame
      struct message received_message = can_read_received_frame();

      // Allocate memory for the message to pass to the handler task
      struct message* received_message_ptr = new struct message(received_message);
      if (received_message_ptr == nullptr) {
        debug_msg(DEBUG_PARTIAL_CAN, "can_message_received_handler_task: memory allocation failed", false, 0);
        vTaskDelete(NULL);
        return;
      }

      // Get the current task's priority to inherit
      UBaseType_t current_task_priority = uxTaskPriorityGet(NULL);
      // Create the handler task
      BaseType_t taskCreated = xTaskCreate(
        can_message_received_handler_task, // Task function
        "can_message_received_handler",    // Name of the task
        2048,                             // Stack size in words
        received_message_ptr,             // Task parameters (pointer to received message)
        current_task_priority,             // Task priority
        NULL                              // Task handle
      );
      if (taskCreated != pdPASS) {
        debug_msg(DEBUG_PARTIAL_CAN, "Failed to create can_message_received_handler_task", false, 0);
        delete received_message_ptr;
      }

    } else if (triggered_alerts & TWAI_ALERT_BUS_ERROR) {

      debug_msg(DEBUG_PARTIAL_CAN, "Bus Error alert triggered", false, 0);

    } else if (triggered_alerts & TWAI_ALERT_TX_FAILED) {

      debug_msg(DEBUG_PARTIAL_CAN, "TX Failed alert triggered", false, 0);

    } else if (triggered_alerts & TWAI_ALERT_RX_QUEUE_FULL) {

      debug_msg(DEBUG_PARTIAL_CAN, "RX queue full alert triggered", false, 0);
      
    }

    vTaskDelay(pdMS_TO_TICKS(100)); // Delay to avoid busy-waiting

  }

}


/**
 * @brief RTOS task handler for processing received CAN messages.
 *
 * This function is designed to be run as a FreeRTOS task. It processes a received CAN message,
 * determines its type and intended recipient, and takes appropriate actions based on the message content.
 * The function supports handling both broadcast and direct messages for the distribution controller,
 * including heartbeat, fault, IO state, ADC read, status, channel current, set current limit, total current,
 * and channel control messages.
 *
 * The function expects a dynamically allocated pointer to a `struct message` as its parameter,
 * which it takes ownership of and deletes after copying.
 *
 * Actions performed by this handler include:
 * - Updating module heartbeat and fault status.
 * - Handling status flags such as "allow off-road" and "blackout".
 * - Creating RTOS tasks for ADC current limit and IO channel control operations.
 * - Logging debug messages for all significant events and message types.
 *
 * After processing the message, the task deletes itself using vTaskDelete(NULL).
 *
 * @param pvParameters Pointer to a dynamically allocated `struct message` containing the received CAN message.
 *                    The memory is freed within the function.
 *
 * @note This function should be used as a FreeRTOS task entry point.
 * @note The function assumes that all necessary global variables and structures (such as `can_modules`,
 *       `can_module_brodcast`, `can_module_disrabution_controler`, `pin_names`, etc.) are properly defined and initialized.
 */
void can_message_received_handler_task(void *pvParameters) {
  // Cast the parameter to a pointer to struct message
  struct message* received_message_ptr = (struct message*)pvParameters;
  if (received_message_ptr == nullptr) {
    debug_msg(DEBUG_PARTIAL_CAN, "can_message_received_handler_task: null parameter", false, 0);
    vTaskDelete(NULL);
    return;
  }
  // Deep copy received_message_ptr to received_message
  struct message received_message;
  received_message.id = received_message_ptr->id;
  received_message.extended = received_message_ptr->extended;
  received_message.type = received_message_ptr->type;
  received_message.single_shot = received_message_ptr->single_shot;
  received_message.data_length_code = received_message_ptr->data_length_code;
  // Deep copy the data array (assuming data is a fixed-size array)
  for (int i = 0; i < 8; ++i) {
    received_message.data[i] = received_message_ptr->data[i];
  }
  // If there are any pointer members in struct message, deep copy them here

  // Free the parameter memory if it was dynamically allocated
  delete received_message_ptr;


  debug_msg(DEBUG_PARTIAL_CAN, "can_message_received_handler called", false, 0);

  debug_msg(DEBUG_PARTIAL_CAN, "Received message with ID:", true, received_message.id);
  debug_msg(DEBUG_PARTIAL_CAN, "Message type:", true, received_message.type);

  if (received_message.id == can_module_brodcast.bus_id) {

    // check if we received an RTR message
    if (received_message.type == FRAME_RTR) {
      debug_msg(DEBUG_PARTIAL_CAN, "Received a RTR message", false, 0);

      //call rtr handler and pass message

      // Allocate memory for the message to pass to the handler task
      struct message* rtr_message_ptr = new struct message(received_message);
      if (rtr_message_ptr == nullptr) {
        debug_msg(DEBUG_PARTIAL_CAN, "Failed to allocate memory for RTR handler", false, 0);
        vTaskDelete(NULL);
        return;
      }
      // Inherit the current task's priority
      UBaseType_t current_task_priority = uxTaskPriorityGet(NULL);
      xTaskCreate(
        can_rtr_message_handler_task, // Task function
        "can_rtr_handler",            // Name of the task
        2048,                        // Stack size in words
        rtr_message_ptr,             // Task parameters (pointer to received message)
        current_task_priority,        // Task priority
        NULL                         // Task handle
      );
    } else {
      debug_msg(DEBUG_PARTIAL_CAN, "Received a data message for distribution controller", false, 0);

      // determine broadcast message type
      switch (received_message.data[0]) {
        case can_paket_type_io_state:
          debug_msg(DEBUG_PARTIAL_CAN, "Received IO state message", false, 0);

          // do nothing not applicable for distribution controller

          break;
        case can_paket_type_status:
          debug_msg(DEBUG_PARTIAL_CAN, "Received status message", false, 0);

          // check if allow_off_road is enabled
          if ((received_message.data[1] & 0b00100000) != 0) {
            debug_msg(DEBUG_PARTIAL_CAN, "Allow off-road is enabled", false, 0);
            io_allow_off_road = true;
          } else {
            debug_msg(DEBUG_PARTIAL_CAN, "Allow off-road is disabled", false, 0);
            io_allow_off_road = false;
          }

          // check if blackout is enabled
          if ((received_message.data[1] & 0b00010000) != 0) {
            debug_msg(DEBUG_PARTIAL_CAN, "Blackout is enabled", false, 0);
            io_blackout_enabled = true;
          } else {
            debug_msg(DEBUG_PARTIAL_CAN, "Blackout is disabled", false, 0);
            io_blackout_enabled = false;
          }

          break;
        case can_paket_type_chanel_set_curent_limit:
          debug_msg(DEBUG_PARTIAL_CAN, "Received channel set current limit message", false, 0);

          // find pin that needs to be set
          for (size_t i = 0; i < sizeof(pin_names) / sizeof(pin_names[0]); i++) {
            if (pin_names[i]->pin_mode == analog_in) {
              if (pin_names[i]->io_chanel_number == received_message.data[1]) {
                // Capture the current pin pointer and current_limit in a struct to pass to the task
                struct AdcTaskParams {
                  pin* p;
                  uint current_limit;
                };
                AdcTaskParams* params = new AdcTaskParams{pin_names[i], (uint)received_message.data[2]};
                if (params == nullptr) {
                  debug_msg(DEBUG_PARTIAL_CAN, "Failed to allocate memory for AdcTaskParams", false, 0);
                  break;
                }
                // Inherit the current task's priority
                UBaseType_t current_task_priority = uxTaskPriorityGet(NULL);
                xTaskCreate([](void* pvParameters) {
                    AdcTaskParams* taskParams = static_cast<AdcTaskParams*>(pvParameters);
                    if (taskParams) {
                      adc_set_ch_current_limit_rtos_wraper(taskParams);
                      delete taskParams; // Free the allocated memory
                    }
                    vTaskDelete(NULL); // Delete the task
                }, "adc_set_chanel_current_limit", 2048, (void*)params, current_task_priority, NULL);
                break; // Exit the loop once the pin is found and task is created
              }
            }
          }
          break;
        case can_paket_type_chanel_control:
          debug_msg(DEBUG_PARTIAL_CAN, "Received channel control message", false, 0);

          for (size_t i = 0; i < sizeof(pin_names) / sizeof(pin_names[0]); i++) {
            if (pin_names[i]->pin_mode == out) {
              if (pin_names[i]->io_chanel_number == received_message.data[1]) {

                // Prepare parameters for the RTOS task
                struct IoTaskParams {
                  pin* p;
                  high_low state;
                };

                high_low state;
                if ((received_message.data[2] & 0x01) == 0) {
                  debug_msg(DEBUG_PARTIAL_CAN, "Channel control message: setting pin to LOW", false, 0);
                  state = low; // Set state to low if the 7th bit is 0
                } else {
                  debug_msg(DEBUG_PARTIAL_CAN, "Channel control message: setting pin to HIGH", false, 0);
                  state = high;
                }

                IoTaskParams* params = new IoTaskParams{pin_names[i], state};
                if (params == nullptr) {
                  debug_msg(DEBUG_PARTIAL_CAN, "Failed to allocate memory for IoTaskParams", false, 0);
                  break;
                }
                // Use a lambda to ensure memory is always freed, even if io_call_rtos_wraper throws
                UBaseType_t current_task_priority = uxTaskPriorityGet(NULL);
                xTaskCreate([](void* pvParameters) {
                    IoTaskParams* taskParams = static_cast<IoTaskParams*>(pvParameters);
                    if (taskParams) {
                      io_call_rtos_wraper(taskParams);
                      delete taskParams; // Free the allocated memory
                    }
                    vTaskDelete(NULL); // Delete the task
                }, "io_channel_control", 2048, (void*)params, current_task_priority, NULL);
                break; // Exit the loop once the pin is found
              }
            }
          }
          break;
        default:
          break;
      }
    }
  }
}


/**
 * @brief Task handler for processing CAN Remote Transmission Request (RTR) messages.
 *
 * This FreeRTOS task handles incoming CAN RTR messages by parsing the message type
 * and performing the appropriate action, such as reading IO states, ADC values,
 * device status, channel current limits, channel currents, or total current.
 * The results are sent back over the CAN bus as response messages.
 *
 * The function expects a dynamically allocated pointer to a `struct message` as its parameter,
 * which it takes ownership of and deletes after use.
 *
 * Supported CAN packet types handled:
 * - can_paket_type_io_state: Reads and returns the current IO channel states.
 * - can_paket_type_adc_read: Reads and returns the ADC value for a specified channel.
 * - can_paket_type_status: Returns the current device status and timestamp.
 * - can_paket_type_chanel_set_curent_limit: Returns the current limit for a specified channel.
 * - can_paket_type_chanel_current: Returns the current reading for a specified channel.
 * - can_paket_type_total_current: Returns the total current across all channels.
 *
 * For each supported type, the function may create additional tasks to perform
 * asynchronous IO or ADC reads, and uses FreeRTOS queues for inter-task communication.
 * After processing, the task deletes itself.
 *
 * @param pvParameters Pointer to a dynamically allocated `struct message` containing the received CAN message.
 */
void can_rtr_message_handler_task (void *pvParameters) {

  debug_msg(DEBUG_PARTIAL_CAN, "can_rtr_message_handler_task called", false, 0);

  // Cast the parameter to a pointer to struct message
  struct message* received_message_ptr = (struct message*)pvParameters;

  // Check if the pointer is null before dereferencing
  if (received_message_ptr == nullptr) {
    debug_msg(DEBUG_PARTIAL_CAN, "can_rtr_message_handler_task: null parameter", false, 0);
    // Clean up any global or static queues if needed
    if (channelStateQueue) xQueueReset(channelStateQueue);
    if (adc_reading_queue) xQueueReset(adc_reading_queue);
    vTaskDelete(NULL);
    return;
  }
  
  struct message received_message = *received_message_ptr;
  // Free the parameter memory if it was dynamically allocated
  delete received_message_ptr;

  // Declare variables used in multiple cases before the switch to avoid jump errors
  struct message outgoing_message;
  uint16_t curent_limit = 0;
  uint16_t channel_current = 0;
  uint16_t total_current = 0;

  switch (received_message.data[0]) {
    case can_paket_type_io_state:
    {
      debug_msg(DEBUG_PARTIAL_CAN, "RTR for IO state received", false, 0);
      
      //create state vars
      uint32_t io_state = 0;

      //struct for return message
      struct message io_state_message;
      io_state_message.id = received_message.id;
      io_state_message.extended = received_message.extended;
      io_state_message.type = FRAME_DATA; // Set the frame type to data
      io_state_message.single_shot = false; // Set single shot flag to false
      io_state_message.data[0] = can_paket_type_io_state; // Set the first byte to the IO state packet type

      // read the curent chanel states
      xTaskCreate(
        io_read_chanel_state, // Task function
        "io_read_rtos",      // Name of the task
        2048,                // Stack size in words
        (void*)channelStateQueue, // Task parameters (pointer to received message)
        uxTaskPriorityGet(NULL), // Inherit parent thread's priority
        NULL                  // Task handle
      );

      if (xQueueReceive(channelStateQueue, &io_state, pdMS_TO_TICKS(1000)) == pdTRUE) {
        debug_msg(DEBUG_PARTIAL_CAN, "IO state read successfully", false, 0);
      } else {
        debug_msg(DEBUG_PARTIAL_CAN, "Failed to read IO state", false, 0);
        xQueueReset(channelStateQueue); // Clean up before early exit
        vTaskDelete(NULL);
        return;
      }

      can_send_frame(io_state_message); // Send the IO state message
      debug_msg(DEBUG_PARTIAL_CAN, "IO state message sent", false, 0);
      // Clean up the queue after use
      xQueueReset(channelStateQueue); // Reset the queue for future use

      break;
    }
    case can_paket_type_adc_read:
    {
      debug_msg(DEBUG_PARTIAL_CAN, "RTR for ADC read received", false, 0);
      // create vars
      uint16_t vref_reading = 0;
      uint16_t channel_reading = 0;
      struct pin pin_to_read;

      //struct for return message
      struct message adc_reading_message;
      adc_reading_message.id = received_message.id;
      adc_reading_message.extended = received_message.extended;
      adc_reading_message.type = FRAME_DATA; // Set the frame type to data
      adc_reading_message.single_shot = false; // Set single shot flag to false

      //find what channel to read
      for (size_t i = 1; i < sizeof(pin_names) / sizeof(pin_names[0]); i++) {
        if (pin_names[i]->adc_channel == received_message.data[1]) {
          pin_to_read = *pin_names[i]; // Copy the pin structure
          debug_msg(DEBUG_PARTIAL_CAN, "Found pin to read ADC:", true, pin_to_read.pin_number);
          break;
        }
      }

      // create task to read adc, passing pin_to_read as parameter
      xTaskCreate(
        adc_read_rtos_wraper, // Task function
        "adc_read_rtos",      // Name of the task
        2048,                 // Stack size in words
        (void*)&pin_to_read,  // Pass pointer to pin_to_read
        uxTaskPriorityGet(NULL), // Inherit parent thread's priority
        NULL                  // Task handle
      );

      //read adc value from queue
      if (xQueueReceive(adc_reading_queue, &channel_reading, pdMS_TO_TICKS(1000)) == pdTRUE) {
        debug_msg(DEBUG_PARTIAL_CAN, "ADC channel reading received", true, channel_reading);
      } else {
        debug_msg(DEBUG_PARTIAL_CAN, "Failed to read ADC channel", false, 0);
        xQueueReset(adc_reading_queue); // Clean up before early exit
        vTaskDelete(NULL);
        return;
      }

      vref_reading = analogRead(ref_12v.pin_number); // Read the Vref pin

      //transmit response
      adc_reading_message.data[0] = can_paket_type_adc_read; // Set the first byte to the ADC read packet type
      adc_reading_message.data[1] = pin_to_read.adc_channel; // Set the ADC channel number
      adc_reading_message.data[2] = channel_reading & 0xFF; // Set the low byte of channel reading
      adc_reading_message.data[3] = (channel_reading >> 8) & 0xFF; // Set the high byte of channel reading
      adc_reading_message.data[4] = vref_reading & 0xFF; // Set the low byte of Vref reading
      adc_reading_message.data[5] = (vref_reading >> 8) & 0xFF; // Set the high byte of Vref reading

      can_send_frame(adc_reading_message); // Send the ADC reading message

      debug_msg(DEBUG_PARTIAL_CAN, "ADC reading message sent", false, 0);
      // Clean up the queue after use
      xQueueReset(adc_reading_queue); // Reset the queue for future use
      break;
    }
      
    case can_paket_type_status:
    {
      debug_msg(DEBUG_PARTIAL_CAN, "RTR for status received", false, 0);
      // setup vars
      uint32_t curent_time = 0;

      //read curent time 
      curent_time = millis();

      // load data into strct
      outgoing_message.id = received_message.id;
      outgoing_message.extended = received_message.extended;
      outgoing_message.type = FRAME_DATA;
      outgoing_message.single_shot = false;

      //load message data
      outgoing_message.data[0] = can_paket_type_status;
      outgoing_message.data[1] = 0; // Zero-initialize before setting bits
      outgoing_message.data[1] |= (can_device_fult & 0x01);
      outgoing_message.data[1] |= ((can_normal_operateing_mode & 0x01) << 1);
      outgoing_message.data[1] |= ((io_allow_off_road & 0x01) << 2);
      outgoing_message.data[1] |= ((io_blackout_enabled & 0x01) << 3);
      outgoing_message.data[2] = curent_time & 0xFF;
      outgoing_message.data[3] = (curent_time >> 8) & 0xFF;
      outgoing_message.data[4] = (curent_time >> 16) & 0xFF;
      outgoing_message.data[5] = (curent_time >> 24) & 0xFF;

      can_send_frame(outgoing_message);
      
      break;
    }
    case can_paket_type_chanel_set_curent_limit: {
      debug_msg(DEBUG_PARTIAL_CAN, "RTR for channel set current limit received", false, 0);
      
      // find what chanel the sender is requesting
      for (size_t i = 1; i < sizeof(pin_names) / sizeof(pin_names[0]); i++) {
          if (pin_names[i]->pin_mode == analog_in) {
            if (pin_names[i]->io_chanel_number == received_message.data[1]) {
              //read the curnt limit
              curent_limit = *(pin_names[i]->chanel_curent_limit_pointer);

              break;
            }
          }
      }

      //load data into outgoing mesage
      outgoing_message.id = received_message.id;
      outgoing_message.extended =received_message.extended;
      outgoing_message.type = FRAME_DATA;
      outgoing_message.single_shot = false;
      outgoing_message.data[0] = can_paket_type_chanel_set_curent_limit;
      outgoing_message.data[1] = received_message.data[1];
      outgoing_message.data[2] = curent_limit & 0xFF;
      outgoing_message.data[3] = (curent_limit >> 8) & 0xFF;

      //send data
      can_send_frame(outgoing_message);

      break;
    }
    case can_paket_type_chanel_current: {
      debug_msg(DEBUG_PARTIAL_CAN, "RTR for channel current received", false, 0);

      // find what chanel the sender is requesting
      for (size_t i = 1; i < sizeof(pin_names) / sizeof(pin_names[0]); i++) {
        if (pin_names[i]->pin_mode == analog_in) {
          if (pin_names[i]->io_chanel_number == received_message.data[1]) {
            //read the channel current
            channel_current = adc_read_ch_current(*pin_names[i]);

            //read chanel current limit
            if (pin_names[i]->chanel_curent_limit_pointer != nullptr) {
              curent_limit = *(pin_names[i]->chanel_curent_limit_pointer);
            }

            debug_msg(DEBUG_PARTIAL_CAN, "Channel current read successfully", true, channel_current);
            
          }
        }
      }

      //load data into outgoing message
      outgoing_message.id = received_message.id;
      outgoing_message.extended = received_message.extended;
      outgoing_message.type = FRAME_DATA;
      outgoing_message.single_shot = false;
      outgoing_message.data[0] = can_paket_type_chanel_current;
      outgoing_message.data[1] = received_message.data[1]; // Channel number
      outgoing_message.data[2] = channel_current & 0xFF; // Low byte of channel current
      outgoing_message.data[3] = (channel_current >> 8) & 0xFF; // High byte of channel current
      outgoing_message.data[4] = curent_limit & 0xFF; // Reserved byte, can be used for future extensions
      outgoing_message.data[5] = (curent_limit >> 8) & 0xFF; // Reserved byte, can be used for future extensions

      //send data
      can_send_frame(outgoing_message);
      debug_msg(DEBUG_PARTIAL_CAN, "Channel current message sent", false, 0);

      break;
    }
    case can_paket_type_total_current: {
      debug_msg(DEBUG_PARTIAL_CAN, "RTR for total current received", false, 0);
      
      // calculate total current
      total_current = 0;
      for (size_t i = 1; i < sizeof(pin_names) / sizeof(pin_names[0]); i++) {
        if (pin_names[i]->pin_mode == analog_in) {
          total_current += *(pin_names[i]->chanel_curent_limit_pointer);
        }
      }

      //load data into outgoing message
      outgoing_message.id = received_message.id;
      outgoing_message.extended = received_message.extended;
      outgoing_message.type = FRAME_DATA;
      outgoing_message.single_shot = false;
      outgoing_message.data[0] = can_paket_type_total_current; // Set the first byte to the total current packet type
      outgoing_message.data[1] = total_current & 0xFF; // Low byte of total current
      outgoing_message.data[2] = (total_current >> 8) & 0xFF; // High byte of total current

      //send data

      can_send_frame(outgoing_message);
      break;
    }
    default:
      debug_msg(DEBUG_PARTIAL_CAN, "Unknown RTR type received", false, 0);
      break;
  }

  vTaskDelete(NULL); // Delete the task after processing
}

/**
 * @brief Sends a CAN heartbeat message and deletes the calling task.
 *
 * This function constructs a CAN heartbeat message using the module's broadcast bus ID
 * and the predefined heartbeat packet type. It sends the message over the CAN bus,
 * logs debug information before and after sending, and then deletes the FreeRTOS task
 * that invoked it.
 *
 * @param pvParameters Pointer to task parameters (unused).
 */
void can_send_heartbeat(void *pvParameters) {
  debug_msg(DEBUG_PARTIAL_CAN, "can_send_heartbeat called", false, 0);

  //setup message
  struct message heartbeat_message;
  while (true) {
    heartbeat_message.id = can_module_brodcast.bus_id;
    heartbeat_message.extended = false;
    heartbeat_message.type = FRAME_DATA; // Set the frame type to data
    heartbeat_message.single_shot = false; // Set single shot flag to false
    heartbeat_message.data[0] = can_paket_type_heartbeat; // Set the first byte to the heartbeat packet type
    heartbeat_message.data_length_code = 1; // Only 1 byte of data

    //send message
    can_send_frame(heartbeat_message);
    
    debug_msg(DEBUG_PARTIAL_CAN, "Heartbeat message sent", false, 0);

    vTaskDelay(pdMS_TO_TICKS(can_heartbeat_interval)); // Delay to ensure the message is sent before next heartbeat
  }
}

/**
 * @brief Monitors the heartbeat status of CAN modules and broadcasts status updates.
 *
 * This function runs in a continuous loop, periodically checking if each CAN module
 * has sent a heartbeat within the allowed timeout interval. If a module fails to send
 * a heartbeat in time, it is marked as not alive, and a heartbeat message is broadcasted
 * to notify other components of its status. The function uses FreeRTOS delay to avoid
 * busy-waiting.
 *
 * @param pvParameters Pointer to parameters for the task (unused).
 *
 * Heartbeat messages are sent with the following data:
 *   - data[0]: Heartbeat packet type identifier.
 *   - data[1]: Lower byte of the module's bus ID.
 *   - data[2]: Upper byte of the module's bus ID.
 *
 * Debug messages are logged for status changes and message transmissions.
 */
void can_check_heartbeat_timer(void *pvParameters) {
  debug_msg(DEBUG_PARTIAL_CAN, "can_check_heartbeat_timer called", false, 0);

  //setup vars
  struct  message heartbeat_message;
  heartbeat_message.id = can_module_brodcast.bus_id;
  heartbeat_message.extended = false;
  heartbeat_message.type = FRAME_DATA; // Set the frame type to data
  heartbeat_message.single_shot = false; // Set single shot flag to false
  heartbeat_message.data[0] = can_paket_type_heartbeat; // Set the first byte to the heartbeat packet type

  // Continuously check if the last heartbeat was received within the interval
  while (true) {
    for (size_t i = 0; i < sizeof(can_modules) / sizeof(can_modules[0]); i++) {
      if (can_modules[i]->is_alive && (millis() - can_modules[i]->last_heartbeat > can_heartbeat_timeout)) {
        can_modules[i]->is_alive = false;
        debug_msg(DEBUG_PARTIAL_CAN, "Module with ID:", true, can_modules[i]->bus_id);
        debug_msg(DEBUG_PARTIAL_CAN, "is not alive anymore", false, 0);

        //send module fult message
        struct message fault_message;
        fault_message.id = can_module_brodcast.bus_id;
        fault_message.extended = false;
        fault_message.type = FRAME_DATA; // Set the frame type to data
        fault_message.single_shot = false; // Set single shot flag to false
        fault_message.data[0] = can_paket_type_module_fult; // Set the first byte to the fault packet type
        fault_message.data[1] = can_modules[i]->bus_id & 0xFF; // Set the module ID in the fault message
        fault_message.data[2] = (can_modules[i]->bus_id >> 8) & 0xFF; // Set the module ID in the fault message
        fault_message.data[3] = 1; // Set the critical fault status to 1 (indicating a fault)
        can_send_frame(fault_message); // Send the fault message

        // Clear the data array to prevent stale data
        memset(heartbeat_message.data, 0, sizeof(heartbeat_message.data));
        heartbeat_message.data[0] = can_paket_type_heartbeat;
        heartbeat_message.data[1] = can_modules[i]->bus_id & 0xFF; // Set the module ID in the heartbeat message
        heartbeat_message.data[2] = (can_modules[i]->bus_id >> 8) & 0xFF; // Set the module ID in the heartbeat message

      }
    }
    // Delay is set to half of can_heartbeat_timeout to ensure timely checks
    vTaskDelay(pdMS_TO_TICKS(can_heartbeat_timeout / 2));
  }
}







#endif // can_cpp
