mickdassive/car_power_management_sytem/(commit log)

2025-05-28 started work on hardware design for the disrabution controler
    [ANALOUGE.kicad_sch, CAN_BUS.kicad_sch, DISTRABUTION.kicad_sch, MCU_IO.kicad_sch, POWER_SUPPLY.kicad_sch, distrabution_controler.kicad_pcb, distrabution_controler.kicad_sch]
2025-05-29 more hardware work
    [ANALOUGE.kicad_sch, CAN_BUS.kicad_sch, DISTRABUTION.kicad_sch, MCU_IO.kicad_sch, POWER_SUPPLY.kicad_sch, distrabution_controler.kicad_pcb, distrabution_controler.kicad_sch]
2025-05-29 MORE PCB WORK
    [ANALOUGE.kicad_sch, DISTRABUTION.kicad_sch, MCU_IO.kicad_sch, POWER_SUPPLY.kicad_sch, distrabution_controler.kicad_pcb]
2025-05-30 more hardware work on disrabution controler nearing ifc
    [MCU_IO.kicad_sch, POWER_SUPPLY.kicad_sch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]
2025-06-06 completed interface controler hardware
    [BUTIONS.kicad_sch, interface_controler.kicad_pcb, interface_controler.kicad_sch]
2025-06-06 working on firmware but notaced a hardware issue
    [DISTRABUTION.kicad_sch, MCU_IO.kicad_sch]
2025-06-06 fixed haredware issue
    [distrabution_controler.kicad_pcb]
2025-06-06 working on adc drivers and starting task handleing
2025-06-06 updated r values
    [ANALOUGE.kicad_sch]
2025-06-08 working on canbus
2025-06-09 working on canbus implimentation
    [can_paket_definitions.ods]
2025-06-10 working on canbus coms
2025-06-19 reworkd some of the adc and can code
    [can_paket_definitions.ods]
2025-07-08 changed programing headder
    [MCU_IO.kicad_sch, distrabution_controler.kicad_pcb]
2025-07-08 fixed programing connector
    [MCU_IO.kicad_sch, distrabution_controler.kicad_pcb]
