mickdassive/car_power_management_sytem/(notices)

Notices in the files:
disrabution_controler/src/adc.cpp:
This program is free software: you can redistribute it and/or modify
it under the terms of the GNU General Public License as published by
the Free Software Foundation, either version 3 of the License.
disrabution_controler/hardware/distrabution_controler.kicad_pcb:
GPL-3.0
